danielwilczak101/EasyControls/README.md

# EasyControls Overview:

ADD IMAGE OF CUBESAT AND FREE FLIER

### [EasyControls.org](http://easycontrols.org)
The website is used to allow users to upload their controls code and see how the spacecraft responds.
