danielwilczak101/EasyControls/ISAAC/RaspberryPi/Readme.md

This is where the code on the raspberry pi will kept. This includes control methods and downloading from the website http://easycontontrols.org
