danielwilczak101/EasyControls/docs/index.md

# Welcome to Easy Controls - Integrated Spacecraft Autonomous Attitude Controls - ISAAC 

Here Dylan will eventually finish the documentation for this project. Maybe... Maybe... he will. 

### How to get started using ISSAC

1. Need to power on ISSAC
