danielwilczak101/EasyControls/ISAAC/Poster.pptx

## EasyControls.org

- F.C.L.R Research Project

- Combine the two teams efforts to build a reusable throttleable rocket that can land and is controlled by using Data Driven “Machine Learning” Controls.

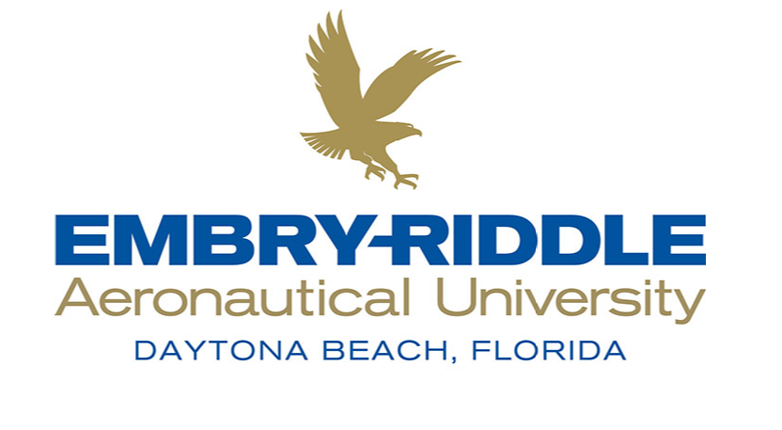
[picture p1: figure]

Mission Overview

- Build Open Source Reusable and Self Landing Liquid Rocket Technology
- Build Open Source Data Driven “Machine Learning” Control Technology

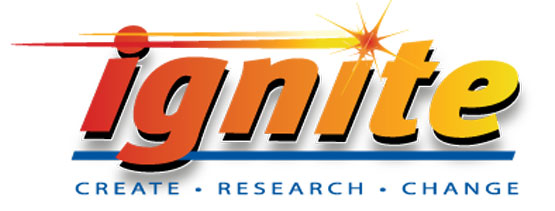
[picture p2: figure]

Data driven “ML” control

Data Driven “Machine Learning” Control Technology

- Rocket Control Prodotype

Reusable and Self Landing Liquid Rocket Technology

By Drawings by Leroy J. Krzycki. China Lake

Notes: To change this poster, replace our sample content with your own. Or, if you'd rather start from a clean slate, use the New Slide button on the Home tab to insert a new page, then enter your text and content in the empty placeholders. If you need more placeholders for titles, subtitles or body text, copy any of the existing placeholders, then drag the new one into place.
