danielwilczak101/EasyControls/ISAAC/Docs/SPARK/ISAAC-Purchase-Form.xlsx

Sheet: Instructions
Please click here to review the OUR Purchasing Guidelines prior to completing this form.
Purchase Request Form: • Used to request the purchase of all supplies/materials as needed. • Group all items by vendor. • Purchase from Amazon whenever possible. • Include any special instructions/details. • Include additional info for electronic and hazardous items in tabs below (required). • Provide direct links to exact item requested. • Provide shipping estimates. • Provide item ID #. • Provide lab/building address for shipment in email.
Electronic, computer & software purchases: • IT APPROVAL REQUIRED. • Provide a brief description of what the item(s) will be used for on the "Electronic Items" tab below. • OUR will obtain IT approval on your behalf. • Includes but not limited to: external hard drives, motherboards, Raspberry Pi, cameras, laptops, printers, etc.
Hazardous, chemical & gas purchases: • EH&S Review and Acceptance REQUIRED before purchasing. • You and your Faculty Mentor are responsible for obtaining a review and acceptance of your comprehensive SOP by the University’s Environmental Health & Safety Office prior to submitting Purchase Requests for hazardous, chemical, or gas purchases. • Complete the “Chemical & Compressed Gas Purchase” form linked in the "Hazardous & Chemicals" Tab below. • Once review is completed by EH&S, submit the acceptance with your Purchase Request Form to the OUR Business Manager and complete "Hazardous & Chemicals" Tab below.
Single Purchases $3,000 or more: • Due to the high expense, a Purchase Requisition must be submitted to purchase the item. • You must provide to the Business Manager along with your completed Purchase Request Form an itemized quote from the vendor and a copy of the vendor’s W-9 Form. • Single Purchases $5,000 or more are considered Capital Requests and require additional paperwork and approvals. • Please plan to purchase items of this nature as soon as possible as it often takes longer to process and receive the item.

Sheet: Purchase Request
 | Student Name: | Jacob R. Romeo |  | Project Title: | Integrated Spacecraft Autonomous Attitude Control |  |  | Type of Funding (Spark, Ignite, Student Internal, SURF): |  | Spark
 | SHIP TO: (Faculty / Lab Director Name) | Engineering Physics Propulsion lab |  | Lab / Building Name and Building # : | COAS |  |  |  | Room # : | 123
 | Group items by vendor and include all relevant information needed for ordering. Email a copy of this to Liz Payne: paynee6@erau.edu.
 | ***Additional info MUST be provided on tabs below for ALL electronic, computer and hazardous/chemical items.***
 |  |  |  |  |  |  | Est. Total for All Items Requested: |  | $975.00 | Actual Total: | $895.30
Line # | Vendor | Item | Product # / SKU | Ordering Instructions / Notes | Link | Quantity | Price Each | Est. Shipping Cost | Estimated Total | Actual Total - Inc. Shipping Fee (Purchaser will complete this) | Notes from Purchaser
1 | Mouser | Voltage Reference | AD586JRZ-REEL7 |  | https://www.mouser.com/ProductDetail/Analog-Devices/AD586JRZ-REEL7?qs=NmRFExCfTkEQ7ye4ZY8tAg%3D%3D | 5 | $11.03 | $9.00 | $70.00 | $64.15
2 | Mouser | ON/OFF switch | 2MS6T4B3M2CES |  | https://www.mouser.com/ProductDetail/Dailywell/2MS6T4B3M2CES?qs=B6kkDfuK7%2FCZhGel7UMMow%3D%3D | 5 | $4.06 | $9.00 | $35.00 | $29.30
3 | Amazon | 3D Filament | B0C3VL4QNM |  | https://www.amazon.com/ELEGOO-Filament-Dimensional-Accuracy-Cardboard/dp/B0C3VL4QNM | 2 | $50.00 | $0.00 | $110.00 | $100.00
4 | JLCPCB | PCBs | N/A | *WILL GIVE LINK FOR ORDER ONCE FINISHED* | "Board is not complete" | 3 | $15.00 | $10.00 | $60.00 | $55.00
5 | VILROS | Raspberry Pi zero | RPZW |  | https://vilros.com/products/raspberry-pi-zero-w?variant=21355432837220 | 3 | $15.00 | $15.00 | $65.00 | $60.00
6 | VILROS | Raspberry Pi 4 | RP4B2GB |  | https://vilros.com/products/raspberry-pi-4-2gb-ram?src=raspberrypi | 3 | $45.00 | $15.00 | $160.00 | $150.00
7 | ALiExpress | Rotary Unions | 3001008L | MAKE SURE IT IS THAT EXACT PART # | https://www.aliexpress.us/item/3256802618228752.html?gatewayAdapt=glo2usa | 8 | $20.00 | $7.00 | $175.00 | $167.00
8 | Amazon | IMU | MPU9250 |  | https://www.googleadservices.com/pagead/aclk?ai=DChcSEwjV-JyC8sSBAxWeRH8AHYyuBDIYABAFGgJvYQ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 | 3 | $15.00 | $10.00 | $60.00 | $55.00
9 | DigiKey | BNO055 | 1528-4646-ND |  | https://www.digikey.com/en/products/detail/adafruit-industries-llc/4646/12609996 | 3 | $29.95 | $15.00 | $110.00 | $104.85
10 | Amazon | Micro SD | SDSQUNB-032G-GN3MN |  | https://www.amazon.com/SanDisk-Ultra-SDSQUNB-032G-GN3MN-UHS-I-microSDHC/dp/B010NE3QHQ?hvadid=309773039951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 | 5 | $8.00 | $5.00 | $50.00 | $45.00
11 | Amazon | wires | B089D29FHC | 25ft | https://www.amazon.com/Fermerry-Stranded-Colors-Flexible-electrical/dp/B089D29FHC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 | 1 | $20.00 | $5.00 | $30.00 | $25.00
12 | Amazon | XT-60 plug | B07VRLQ2C5 |  | https://www.amazon.com/XT60PW-Female-Connector-Adapter-Battery/dp/B07VRLQ2C5 | 2 | $10.00 | $5.00 | $30.00 | $25.00
13 | Amazon | JST | B0B152V2W8 |  | https://www.amazon.com/Twidec-Connector-Housing-Adapter-Terminal/dp/B0B152V2W8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 | 1 | $10.00 | $5.00 | $20.00 | $15.00
14 |  |  |  |  |  |  |  |  |  | $0.00
15 |  |  |  |  |  |  |  |  |  | $0.00
16 |  |  |  |  |  |  |  |  | $0.00 | $0.00
17 |  |  |  |  |  |  |  |  | $0.00 | $0.00
18 |  |  |  |  |  |  |  |  | $0.00 | $0.00
19 |  |  |  |  |  |  |  |  | $0.00 | $0.00
20 |  |  |  |  |  |  |  |  | $0.00 | $0.00
21 |  |  |  |  |  |  |  |  | $0.00 | $0.00
22 |  |  |  |  |  |  |  |  | $0.00 | $0.00
23 |  |  |  |  |  |  |  |  | $0.00 | $0.00
24 |  |  |  |  |  |  |  |  | $0.00 | $0.00
25 |  |  |  |  |  |  |  |  | $0.00 | $0.00
26 |  |  |  |  |  |  |  |  | $0.00 | $0.00
27 |  |  |  |  |  |  |  |  | $0.00 | $0.00
28 |  |  |  |  |  |  |  |  | $0.00 | $0.00
29 |  |  |  |  |  |  |  |  | $0.00 | $0.00
30 |  |  |  |  |  |  |  |  | $0.00 | $0.00
31 |  |  |  |  |  |  |  |  | $0.00 | $0.00
32 |  |  |  |  |  |  |  |  | $0.00 | $0.00
33 |  |  |  |  |  |  |  |  | $0.00 | $0.00
34 |  |  |  |  |  |  |  |  | $0.00 | $0.00
35 |  |  |  |  |  |  |  |  | $0.00 | $0.00
36 |  |  |  |  |  |  |  |  | $0.00 | $0.00
37 |  |  |  |  |  |  |  |  | $0.00 | $0.00
38 |  |  |  |  |  |  |  |  | $0.00 | $0.00
39 |  |  |  |  |  |  |  |  | $0.00 | $0.00
40 |  |  |  |  |  |  |  |  | $0.00 | $0.00
41 |  |  |  |  |  |  |  |  | $0.00 | $0.00
42 |  |  |  |  |  |  |  |  | $0.00 | $0.00
43 |  |  |  |  |  |  |  |  | $0.00 | $0.00
44 |  |  |  |  |  |  |  |  | $0.00 | $0.00
45 |  |  |  |  |  |  |  |  | $0.00 | $0.00
46 |  |  |  |  |  |  |  |  | $0.00 | $0.00
47 |  |  |  |  |  |  |  |  | $0.00 | $0.00
48 |  |  |  |  |  |  |  |  | $0.00 | $0.00
49 |  |  |  |  |  |  |  |  | $0.00 | $0.00
50 |  |  |  |  |  |  |  |  | $0.00 | $0.00
51 |  |  |  |  |  |  |  |  | $0.00 | $0.00
52 |  |  |  |  |  |  |  |  | $0.00 | $0.00
53 |  |  |  |  |  |  |  |  | $0.00 | $0.00
54 |  |  |  |  |  |  |  |  | $0.00 | $0.00
55 |  |  |  |  |  |  |  |  | $0.00 | $0.00
56 |  |  |  |  |  |  |  |  | $0.00 | $0.00
57 |  |  |  |  |  |  |  |  | $0.00 | $0.00
58 |  |  |  |  |  |  |  |  | $0.00 | $0.00
59 |  |  |  |  |  |  |  |  | $0.00 | $0.00
60 |  |  |  |  |  |  |  |  | $0.00 | $0.00
61 |  |  |  |  |  |  |  |  | $0.00 | $0.00
62 |  |  |  |  |  |  |  |  | $0.00 | $0.00
63 |  |  |  |  |  |  |  |  | $0.00 | $0.00
64 |  |  |  |  |  |  |  |  | $0.00 | $0.00
65 |  |  |  |  |  |  |  |  | $0.00 | $0.00
66 |  |  |  |  |  |  |  |  | $0.00 | $0.00
67 |  |  |  |  |  |  |  |  | $0.00 | $0.00
68 |  |  |  |  |  |  |  |  | $0.00 | $0.00
69 |  |  |  |  |  |  |  |  | $0.00 | $0.00
70 |  |  |  |  |  |  |  |  | $0.00 | $0.00
71 |  |  |  |  |  |  |  |  | $0.00 | $0.00
72 |  |  |  |  |  |  |  |  | $0.00 | $0.00
73 |  |  |  |  |  |  |  |  | $0.00 | $0.00
74 |  |  |  |  |  |  |  |  | $0.00 | $0.00
75 |  |  |  |  |  |  |  |  | $0.00 | $0.00
76 |  |  |  |  |  |  |  |  | $0.00 | $0.00
77 |  |  |  |  |  |  |  |  | $0.00 | $0.00
78 |  |  |  |  |  |  |  |  | $0.00 | $0.00
79 |  |  |  |  |  |  |  |  | $0.00 | $0.00
80 |  |  |  |  |  |  |  |  | $0.00 | $0.00
81 |  |  |  |  |  |  |  |  | $0.00 | $0.00
82 |  |  |  |  |  |  |  |  | $0.00 | $0.00
83 |  |  |  |  |  |  |  |  | $0.00 | $0.00
84 |  |  |  |  |  |  |  |  | $0.00 | $0.00
85 |  |  |  |  |  |  |  |  | $0.00 | $0.00
86 |  |  |  |  |  |  |  |  | $0.00 | $0.00
87 |  |  |  |  |  |  |  |  | $0.00 | $0.00
88 |  |  |  |  |  |  |  |  | $0.00 | $0.00
89 |  |  |  |  |  |  |  |  | $0.00 | $0.00
90 |  |  |  |  |  |  |  |  | $0.00 | $0.00
91 |  |  |  |  |  |  |  |  | $0.00 | $0.00
92 |  |  |  |  |  |  |  |  | $0.00 | $0.00
93 |  |  |  |  |  |  |  |  | $0.00 | $0.00
94 |  |  |  |  |  |  |  |  | $0.00 | $0.00
95 |  |  |  |  |  |  |  |  | $0.00 | $0.00
96 |  |  |  |  |  |  |  |  | $0.00 | $0.00
97 |  |  |  |  |  |  |  |  | $0.00 | $0.00
98 |  |  |  |  |  |  |  |  | $0.00 | $0.00
99 |  |  |  |  |  |  |  |  | $0.00 | $0.00
100 |  |  |  |  |  |  |  |  | $0.00 | $0.00
 |  |  |  |  |  |  |  |  | $0.00 | $0.00

Sheet: Electronic Items
All electronic, computer, and technology items must be approved by IT prior to purchasing. The info below is required so that we can obtain IT approval on your behalf.
Line # from Purchase Request Form | Justification (why is the item needed, where will it be used / stored, will it be connected to the University network, etc.)
5 | For testing and upgrades and future development
6 | For testing and upgrades as well as future development

Sheet: Hazardous & Chemical Items
ALL hazardous and chemical items require review and acceptance by Environmental Health & Safety. You and your Faculty Mentor are required to obtain EH&S review and acceptance of a comprehensive SOP prior to requesting hazardous items.
Line # from Purchase Request Form | Link to Safety Data Sheet | Chemical & Compressed Gas Purchase Form submitted to EH&S for hazardous items? Select Yes or No (https://ernie.erau.edu/Departments/ehs/Pages/Forms.aspx) | SOP Reviewed and Accepted by EH&S? Select Yes or No
