danielwilczak101/EasyControls/Cubesat/PCB/CubeSat/CubeSat.step

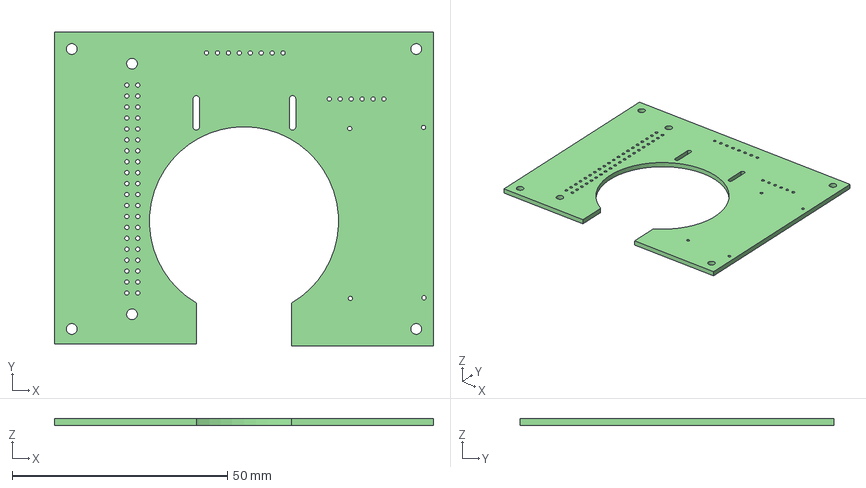
[picture p9: CAD file, 2022-09-25]
Cubesat/PCB/CubeSat/CubeSat.step
88.0 x 73.0 x 1.60 mm
