danielwilczak101/EasyControls/Cubesat/PCB/MJBOTS-CubeSat/CubeSat.step

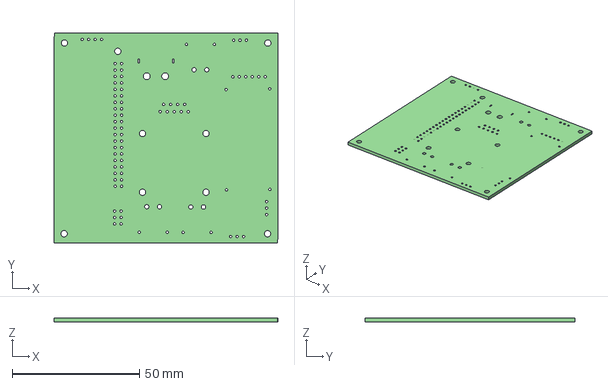
[picture p10: CAD file, 2022-11-11]
Cubesat/PCB/MJBOTS-CubeSat/CubeSat.step
88.1 x 82.7 x 1.60 mm
