danielwilczak101/EasyControls/ISAAC/PCB/Pi_HAT/V5/Pi_HAT_V5_Simple/Symbols/BSS138_RFG.step

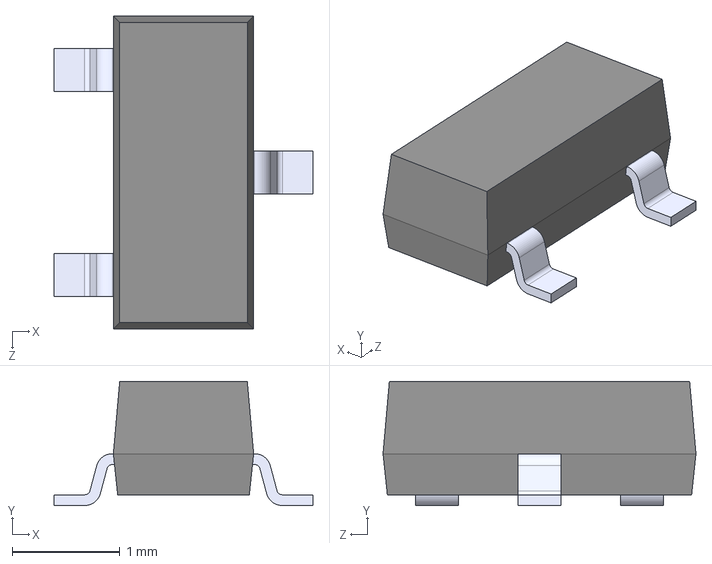
[picture p11: CAD file, 2022-09-25]
ISAAC/PCB/Pi_HAT/V5/Pi_HAT_V5_Simple/Symbols/BSS138_RFG.step
2.40 x 1.15 x 2.90 mm
