danielwilczak101/EasyControls/ISAAC/PCB/Spacecraft ATmega328 MOSFET/kicad_library/3DModel/ECS-160-20-5PXDN-TR.step

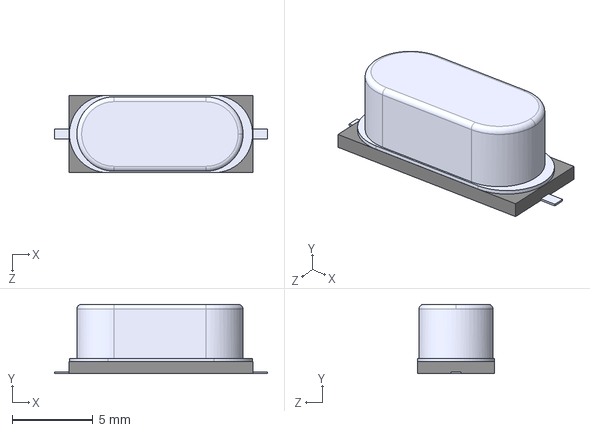
[picture p12: CAD file, 2022-04-26]
ISAAC/PCB/Spacecraft ATmega328 MOSFET/kicad_library/3DModel/ECS-160-20-5PXDN-TR.step
13.2 x 4.30 x 4.80 mm
