danielwilczak101/EasyControls/ISAAC/PCB/Pi_HAT/V5/Pi_HAT_V5_Simple/Symbols/XT60PW-M.step

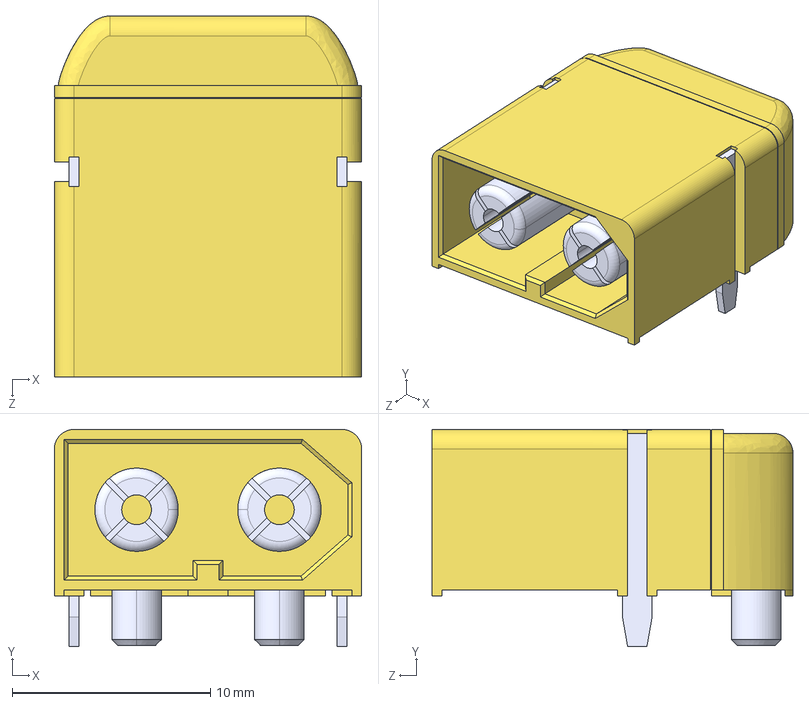
[picture p13: CAD file, 2022-04-24]
ISAAC/PCB/Pi_HAT/V5/Pi_HAT_V5_Simple/Symbols/XT60PW-M.step
15.5 x 10.9 x 18.2 mm
