danielwilczak101/EasyControls/ISAAC/PCB/Spacecraft ATmega328 MOSFET/kicad_library/3DModel/T491A104K035AT.step

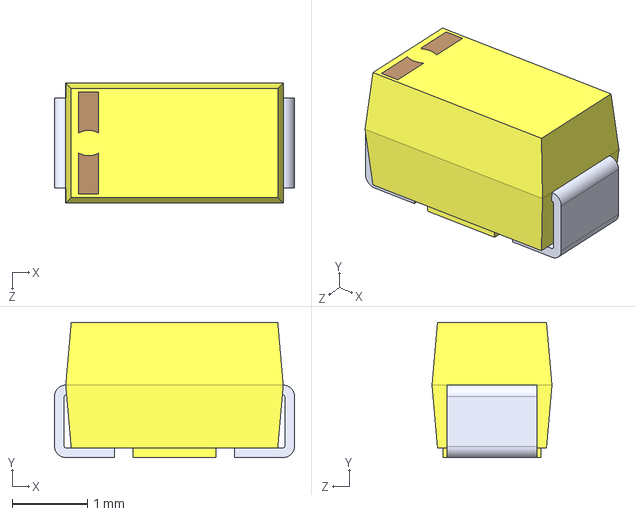
[picture p14: CAD file, 2022-04-26]
ISAAC/PCB/Spacecraft ATmega328 MOSFET/kicad_library/3DModel/T491A104K035AT.step
3.20 x 1.80 x 1.60 mm
