danielwilczak101/EasyControls/ISAAC/PCB/Pi_HAT/V5/Pi_HAT_V5_Simple/Symbols/VREG_L7805ACD2T.step

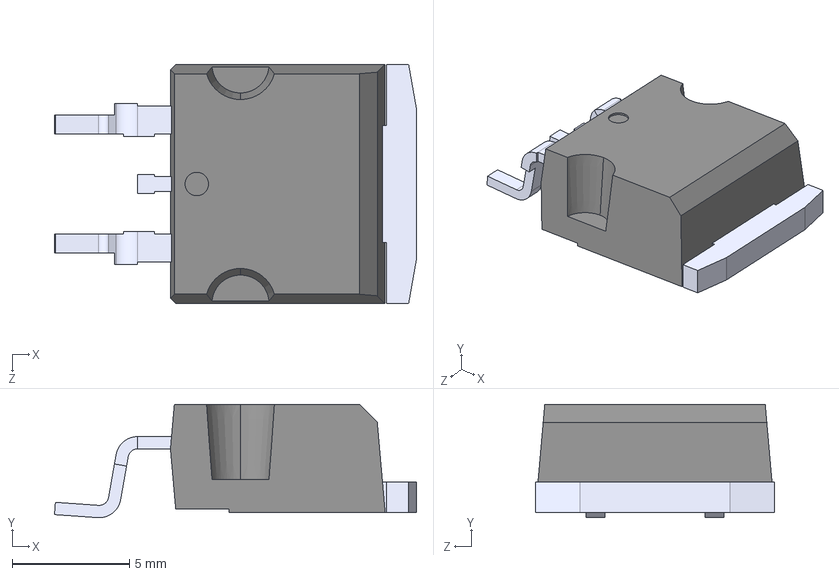
[picture p15: CAD file, 2022-04-24]
ISAAC/PCB/Pi_HAT/V5/Pi_HAT_V5_Simple/Symbols/VREG_L7805ACD2T.step
15.4 x 4.83 x 10.2 mm
