danielwilczak101/EasyControls/ISAAC/PCB/Spacecraft ATmega328 MOSFET/kicad_library/3DModel/BOB-12009.step

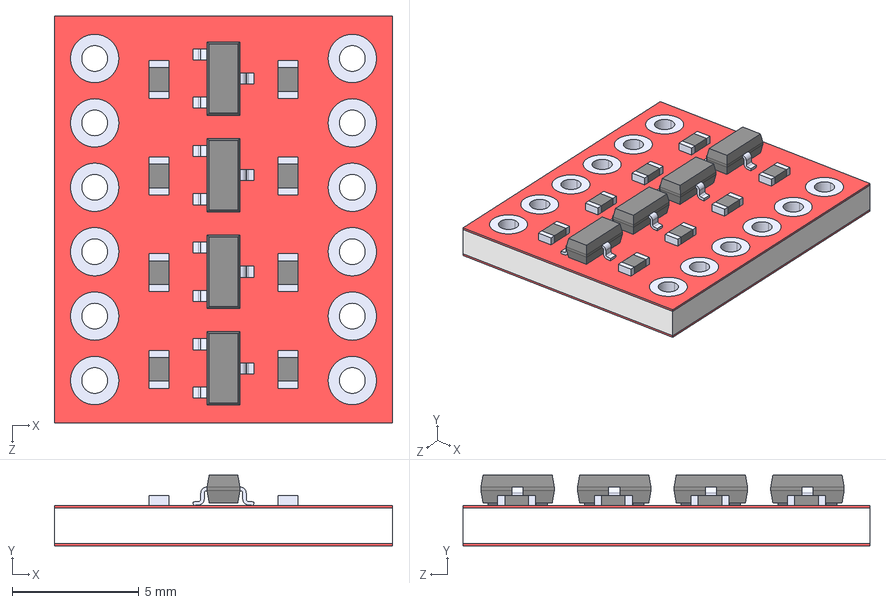
[picture p16: CAD file, 2022-04-26]
ISAAC/PCB/Spacecraft ATmega328 MOSFET/kicad_library/3DModel/BOB-12009.step
13.3 x 2.80 x 16.1 mm
