danielwilczak101/EasyControls/ISAAC/testing/README.md

All testing requirements will be accomplished in this directory.

### How it works:
1. State test requirement in general language.  
2. State non requirements.  
3. State what is expected after the test. (files,diagrams, etc).  

### Optional:
1. State any required information the test might need to accomplish the test.  

### How to make test - Example:
```
## Test Requirements:
Assemble mosfet board and fire valve.   
    - Tank pressue is optional but please detail in readme.  
    - Does not require I2C communication to the chip.  

## File Requirements:  
1.Ardunio Code.  
2.Wiring Diagram(Hand written or drawen out).  
```
