danielwilczak101/EasyControls/ISAAC/testing/IMUData/README.md

This file contains the code in development to retrieve IMU data from the Arduino to the Raspberry Pi.
