danielwilczak101/EasyControls/ISAAC/testing/pi_ssh_and_vnc/README.md

## Test Completed:
Setup Raspberry Pi on spacecraft with SSH. 
    - Be on lab Wifi.  
    - Run python script to validate everything works.

## File Requirements:
1. Python Code.  
2. Connection details.

# SSH Connection

### For Linux/Mac open up terminal window and type:
```bash
ssh pi@192.168.88.80
```
Enter Password: Dmw0234567 

Congratulations you succesfully SSH into the Raspberry Pi! 

### For Windows downlaod an SSH client like Putty:

Link to Download Putty:
https://www.chiark.greenend.org.uk/~sgtatham/putty/latest.html

Open Putty and select SSH

Enter
```
IP Adress: 192.168.88.80
Username: pi
Password: Dmw0234567
```
Congratulations you succesfully SSH into the Raspberry Pi! 

# VNC Connection

### For Linux, Mac, and Windows download VNC Viewer Application

Link to Download VNC Viewer:
https://www.realvnc.com/en/connect/download/viewer/

In order to connect:
```
Enter IP Address: 192.168.88.80

Enter Username: pi

Enter Password: Dmw0234567
```

Congratulations you succesfully VNC into the Raspberry Pi! 

4. Instructions on how to set this up.
5. (Optional) Find or ask dan for cheap router so we can have this setup for the confrence.
