danielwilczak101/EasyControls/ISAAC/testing/tank_servo/README.md

## Test Completed:
Testing information below.

## Servo info
Model - HS-7980TH

## Big things to note
```C++
// Perpindicular to the pipe 
Servo1.write(45); 
   
// Parrellel to the pipe
Servo1.write(140); 
```

## Wiring
```
White  - PWM
Orange - 5v
Blue   - Gnd
```

## Image
Wiring Breadboard
