danielwilczak101/EasyControls/ISAAC/testing/tank_thermocouple/README.md

## Test Completed:
Read thermocouple data that comes from the tank. 
    - Read tank thermocouple data.  

## File Requirements:
1. Python Code or ardunio code.  
2. Wiring diagram (Can be hand written or drawn out).

## Wiring
CS - Any digital pin (default GPIO 17, board pin 11)  
SCK - SCLK (GPIO 11)  
SDO - MISO (GPIO 9)  
SDI - MOSO (GPIO 10)  
Vin - 5V or 3V  
GND - Ground
