danielwilczak101/EasyControls/ISAAC/testing/thruster_force/README.md

## Test Completed:
Assemble pressurize valve to operationg pressure and see how many Newtons of force it produces over time.   

### Thrust values:
Thrust from test stand nozzle with following psi going to the solinoid.
```
40 psi = 30g
60 psi = 60g
80 psi = 90g
95 psi  = 101 - 105g
100 psi = 100 - 113g 
130 psi = 130 - 136g
```
    
Wiring Breadboard

Wiring Breadboard
