danielwilczak101/EasyControls/ISAAC/testing/thruster_led/README.md

## Test Completed:
Test LED curcuit that uses digital signal to change the leds.   
    - Show firing of left and right.
    - CHange colors.
    - Does not require I2C communication to the chip.  

## File Requirements:
1.Ardunio Code.  

## Wiring
5v to 5v
Gnd to Gnd
DIN to digital pin 2 or whatever we want

## Color picker
https://www.google.com/search?q=rgb+color+picker

## Purchased LEDS
https://www.adafruit.com/product/1426  

## Tutorial:  
https://learn.adafruit.com/adafruit-neopixel-uberguide/arduino-library-use  

## Image
Wiring Breadboard
