danielwilczak101/EasyControls/ISAAC/testing/thruster_firing/README.md

## Test Requirements:
Assemble mosfet board and fire valve.   
    - Use lab pressure. See what the fastest speed we can oscillate the solinoid before it locks.
    - Does not require I2C communication to the chip.  

## File Requirements:
1.Ardunio Code.  
2.Wiring Diagram(Hand written or drawen out).
