danielwilczak101/EasyControls/ISAAC/testing/atmega328PAU_bootloader_program/images/1.png

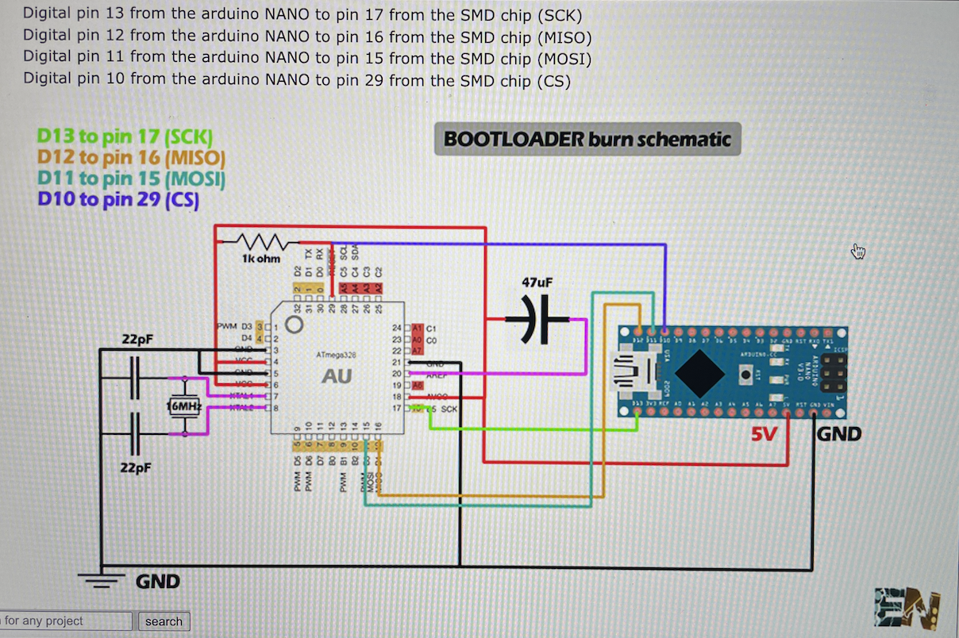
ISAAC/testing/atmega328PAU_bootloader_program/images/1.png
