danielwilczak101/EasyControls/ISAAC/PCB/Pi_HAT/V5/Pi_HAT_V5_Simple/Pi_HAT_V5_Simple.kicad_pcb

## KiCad design ISAAC/PCB/Pi_HAT/V5/Pi_HAT_V5_Simple/Pi_HAT_V5_Simple.kicad_pcb (2024-03-04)

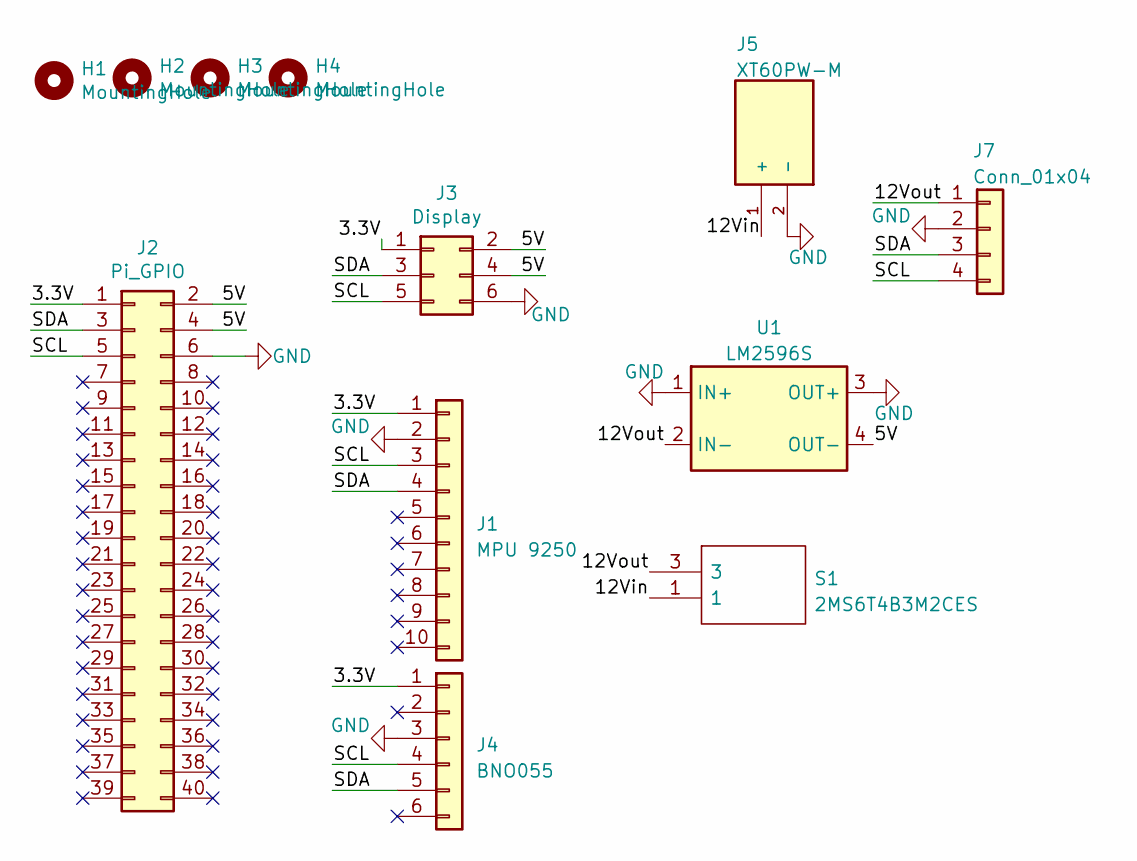
[picture p26: schematic Pi_HAT_V5_Simple.kicad_sch]

Parts:
H1, H2, H3, H4: MountingHole; MountingHole_2.5mm
J1: MPU 9250; PinHeader_1x10_P2.54mm_Vertical
J2: Pi_GPIO; PinHeader_2x20_P2.54mm_Vertical
J3: Display; PinHeader_2x03_P2.54mm_Vertical
J4: BNO055; PinHeader_1x06_P2.54mm_Vertical
J5: XT60PW-M; AMASS_XT60PW-M; PARTREV V1.2
J7: Conn_01x04; PinHeader_1x04_P2.54mm_Vertical
S1: 2MS6T4B3M2CES; Mouser Part Number 118-2MS6T4B3M2CES
U1: LM2596S; LM2596S_mod

Connections:
/3.3V: J1.1, J2.1, J3.1, J4.1
/5V: J2.2, J2.4, J3.2, J3.4, U1.4 (OUT-)
/12Vin: J5.1 (+), S1.1
/12Vout: J7.1, S1.3, U1.2 (IN-)
/SCL: J1.3, J2.5, J3.5, J4.4, J7.4
/SDA: J1.4, J2.3, J3.3, J4.5, J7.3
GND: J1.2, J2.6, J3.6, J4.3, J5.2 (-), J7.2, U1.1 (IN+), U1.3 (OUT+)

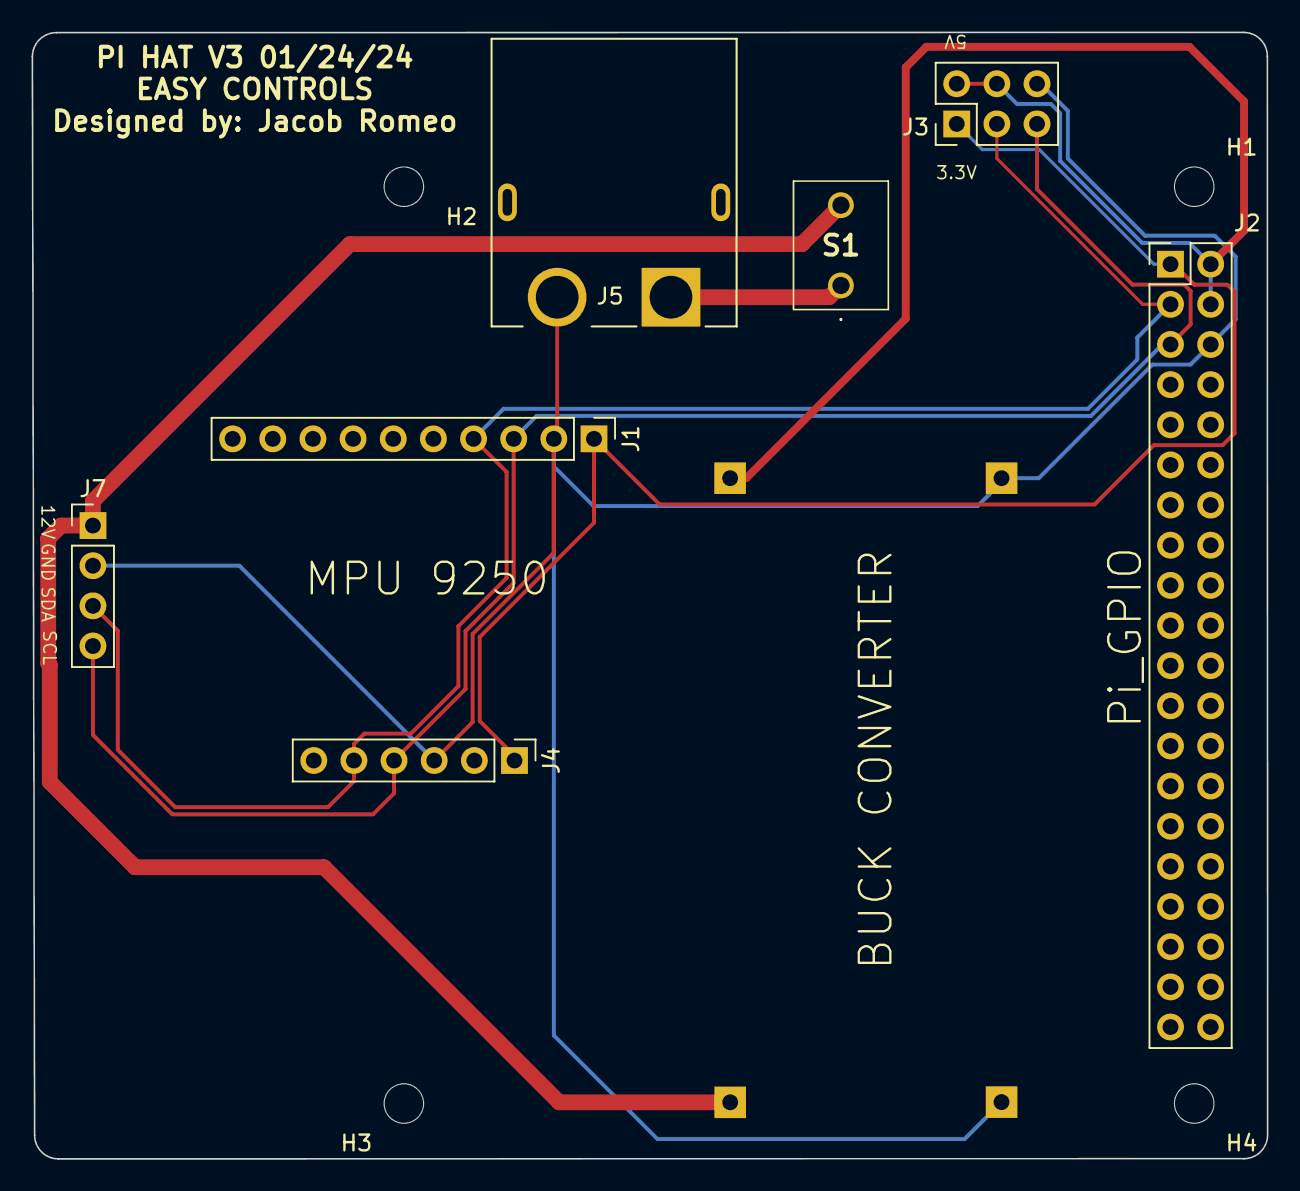
[picture p27: board Pi_HAT_V5_Simple.kicad_pcb from above]

Board: 2 copper layers, 78.1 x 71.3 mm, 12 parts (1 on the bottom side), 7 nets.
