danielwilczak101/EasyControls/ISAAC/PCB/Pi_HAT/V4/Pi_HAT_V4/Pi_HAT_V4.kicad_pcb

## KiCad design ISAAC/PCB/Pi_HAT/V4/Pi_HAT_V4/Pi_HAT_V4.kicad_pcb (2024-02-06, an earlier design)

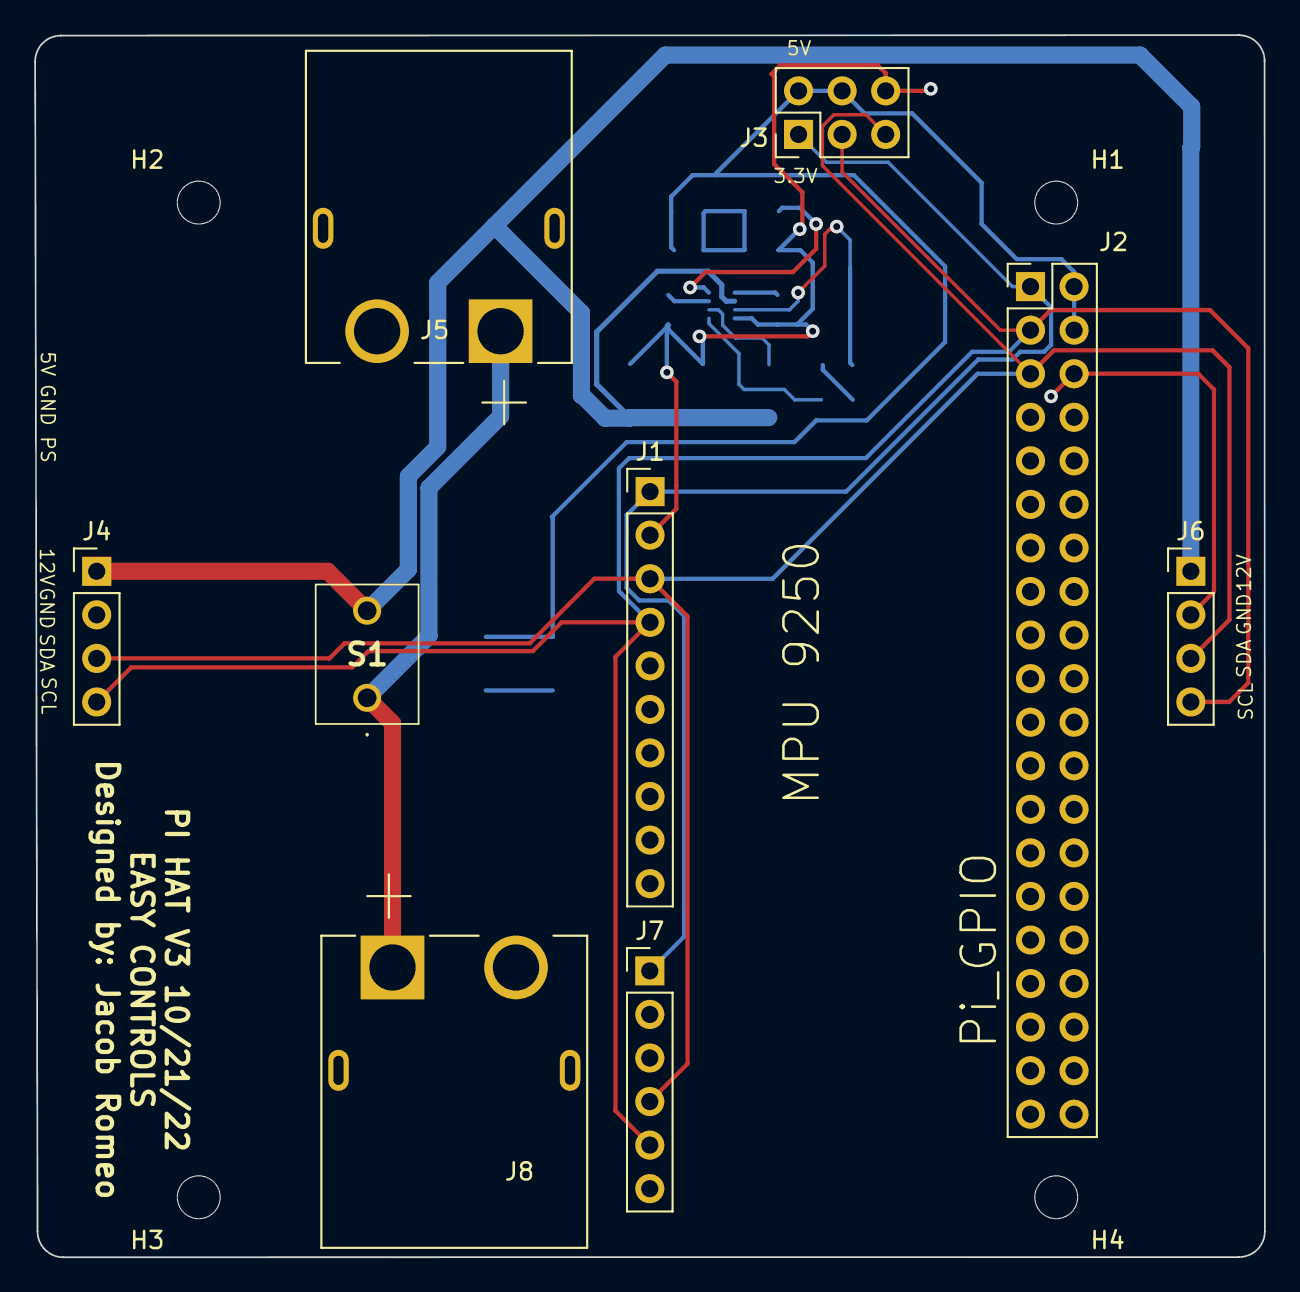
[picture p28: board Pi_HAT_V4.kicad_pcb from above]

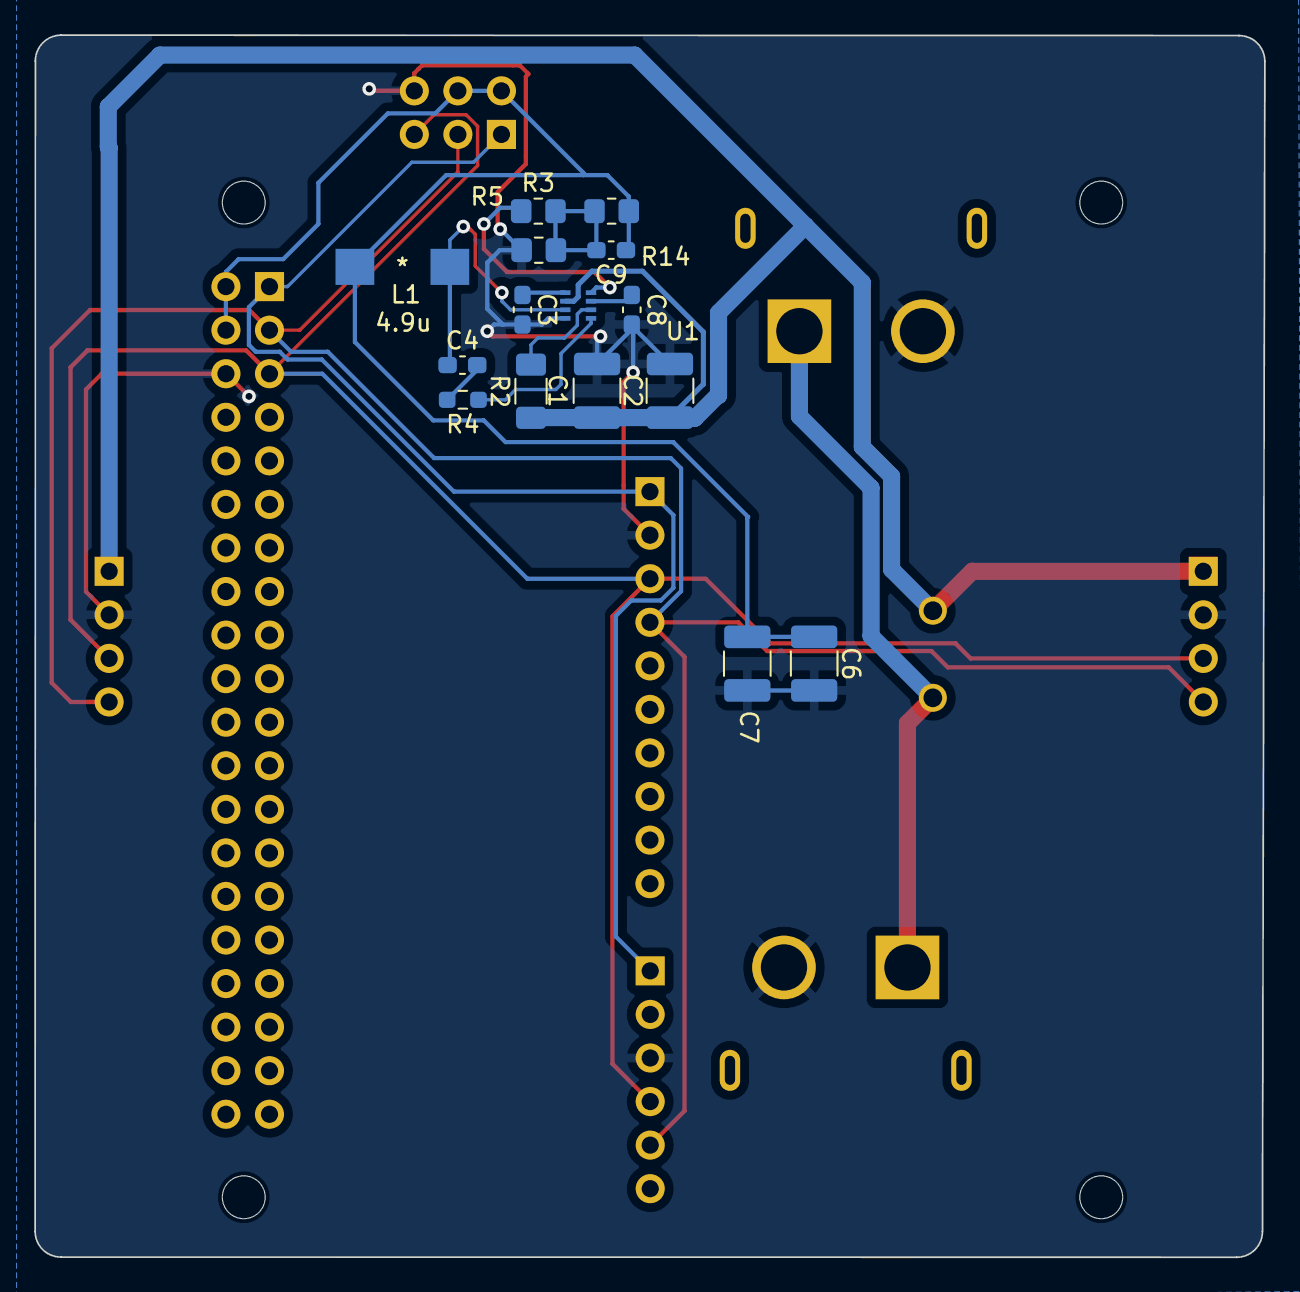
[picture p29: board Pi_HAT_V4.kicad_pcb from below]

Board: 2 copper layers, 71.7 x 71.3 mm, 28 parts (15 on the bottom side), 15 nets.

Parts:
C1, C6, C7: 22u; C_1210_3225Metric_Pad1.33x2.70mm_HandSolder
C2: 0.1u; C_1210_3225Metric_Pad1.33x2.70mm_HandSolder
C3: 1n; C_0603_1608Metric_Pad1.08x0.95mm_HandSolder
C4: 1u; C_0603_1608Metric_Pad1.08x0.95mm_HandSolder
C8: 6.8n; C_0603_1608Metric_Pad1.08x0.95mm_HandSolder
C9: 10p; C_0603_1608Metric_Pad1.08x0.95mm_HandSolder
H1, H2, H3, H4: MountingHole; MountingHole_2.5mm
J1: MPU 9250; PinHeader_1x10_P2.54mm_Vertical
J2: Pi_GPIO; PinHeader_2x20_P2.54mm_Vertical
J3: Display; PinHeader_2x03_P2.54mm_Vertical
J4, J6: Conn_01x04_Male; PinHeader_1x04_P2.54mm_Vertical
J5, J8: XT60PW-M; AMASS_XT60PW-M
J7: BNO055; PinHeader_1x06_P2.54mm_Vertical
L1: 4.9u; 744777004
R2: 604k; R_1206_3216Metric_Pad1.30x1.75mm_HandSolder
R3: 15k; R_0805_2012Metric_Pad1.20x1.40mm_HandSolder
R4: 20; R_0603_1608Metric_Pad0.98x0.95mm_HandSolder
R5: 7.68K; R_0805_2012Metric_Pad1.20x1.40mm_HandSolder
R14: 40.2k; R_0805_2012Metric_Pad1.20x1.40mm_HandSolder
S1: Switch; 2MS6T4B3M2CES
U1: MP2315GJ-Z; MP2393GTL-P

Connections:
/3.3V: J1.1, J2.1, J3.1, J7.1
/5V: C6.1, C7.1, C9.1, J2.2, J2.4, J3.2, J3.4, L1.2, R14.1
/12V: C1.1, C2.1, J4.1, J6.1, R2.1, S1.3, U1.2 (IN)
/Buck Converter/12Vin: J5.1 (+), J8.1 (+), S1.1
/SCL: J1.3, J2.5, J3.5, J4.3, J6.3, J7.4
/SDA: J1.4, J2.3, J3.3, J4.4, J6.4, J7.5
GND: C1.2, C2.2, C3.2, C6.2, C7.2, C8.2, J1.2, J2.6, J3.6, J4.2, J5.2 (-), J6.2, J7.3, J8.2 (-), R5.1, U1.4 (GND)
unnamed: C4.2, R4.2
unnamed: C9.2, R3.2, R5.2, R14.2
unnamed: R4.1, U1.5 (BST)
unnamed: R2.2, U1.6 (EN/SYNC)
unnamed: R3.1, U1.8 (FB)
unnamed: C3.1, U1.1 (PG)
unnamed: C8.1, U1.7 (SS)
unnamed: C4.1, L1.1, U1.3 (SW)
