danielwilczak101/EasyControls/ISAAC/PCB/Pi_HAT/V3/Pi_HAT_V3_simple/Pi_HAT_Simple_V3.kicad_pcb

## KiCad design ISAAC/PCB/Pi_HAT/V3/Pi_HAT_V3_simple/Pi_HAT_Simple_V3.kicad_pcb (2022-11-24, an earlier design)

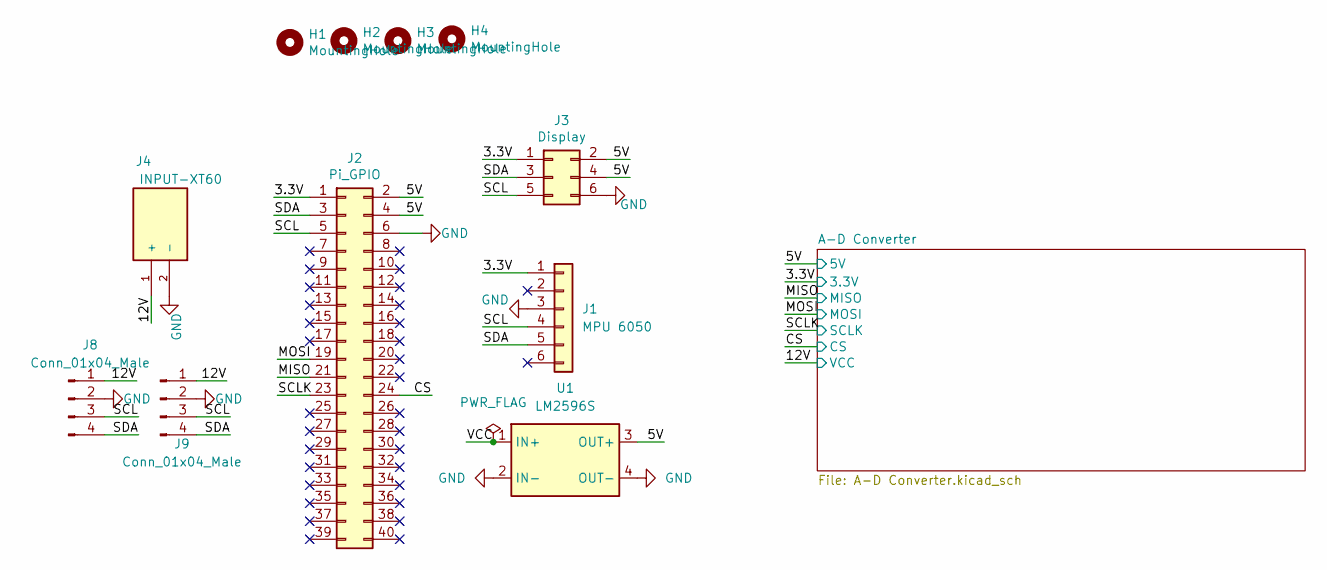
[picture p30: schematic Pi_HAT_Simple_V3.kicad_sch]

Parts:
H1, H2, H3, H4: MountingHole; MountingHole_2.5mm
J1: MPU 6050; PinHeader_1x06_P2.54mm_Vertical
J2: Pi_GPIO; PinHeader_2x20_P2.54mm_Vertical
J3: Display; PinHeader_2x03_P2.54mm_Vertical
J4: INPUT-XT60; AMASS_XT60PW-M; PARTREV V1.2
J8, J9: Conn_01x04_Male; PinHeader_1x04_P2.54mm_Vertical
U1: LM2596S; LM2596S_mod

Connections:
/3.3V: J1.1, J2.1, J3.1; also elsewhere on the board
/5V: J2.2, J2.4, J3.2, J3.4, U1.3 (OUT+); also elsewhere on the board
/12V: J4.1 (+), J8.1, J9.1; also elsewhere on the board
/CS: J2.24; also elsewhere on the board
/MISO: J2.21; also elsewhere on the board
/MOSI: J2.19; also elsewhere on the board
/SCL: J1.4, J2.5, J3.5, J8.3, J9.3
/SCLK: J2.23; also elsewhere on the board
/SDA: J1.5, J2.3, J3.3, J8.4, J9.4
/VCC: U1.1 (IN+)
GND: J1.3, J2.6, J3.6, J4.2 (-), J8.2, J9.2, U1.2 (IN-), U1.4 (OUT-); also elsewhere on the board

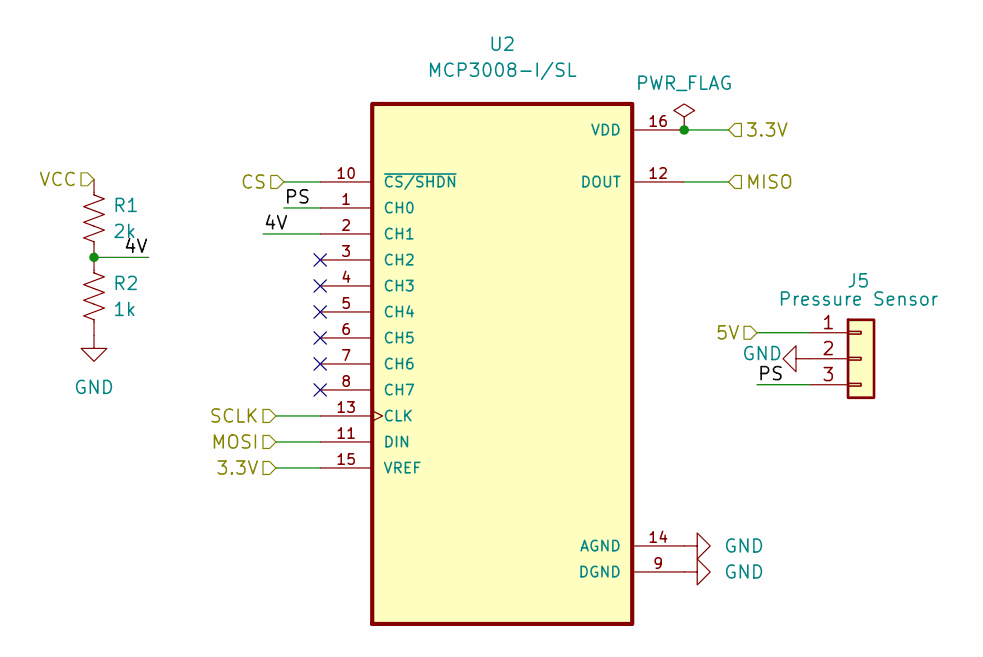
[picture p31: schematic A-D Converter.kicad_sch]

Parts:
J5: Pressure Sensor; PinHeader_1x03_P2.54mm_Vertical
R1: 2k; R_0805_2012Metric_Pad1.20x1.40mm_HandSolder
R2: 1k; R_0805_2012Metric_Pad1.20x1.40mm_HandSolder
U2: MCP3008-I/SL; SOIC127P600X175-16N

Connections:
/3.3V: U2.15 (VREF), U2.16 (VDD); also elsewhere on the board
/5V: J5.1; also elsewhere on the board
/12V: R1.1; also elsewhere on the board
/A-D Converter/4V: R1.2, R2.1, U2.2 (CH1)
/A-D Converter/PS: J5.3, U2.1 (CH0)
/CS: U2.10 (~CS/SHDN); also elsewhere on the board
/MISO: U2.12 (DOUT); also elsewhere on the board
/MOSI: U2.11 (DIN); also elsewhere on the board
/SCLK: U2.13 (CLK); also elsewhere on the board
GND: J5.2, R2.2, U2.9 (DGND), U2.14 (AGND); also elsewhere on the board

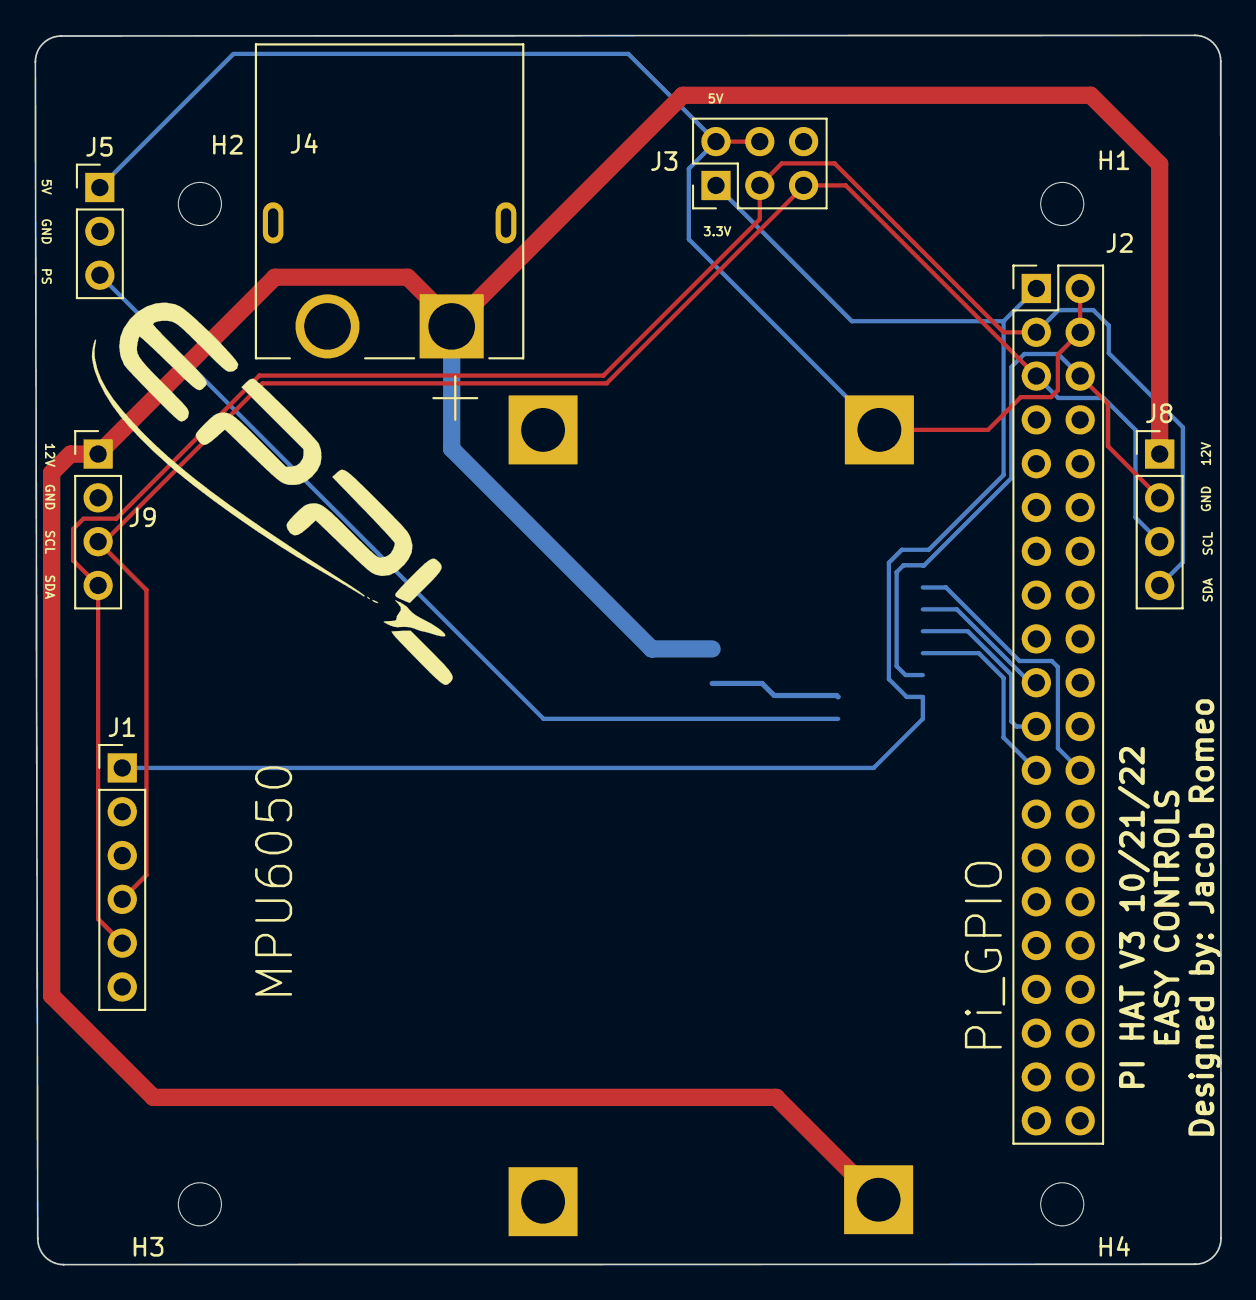
[picture p32: board Pi_HAT_Simple_V3.kicad_pcb from above]

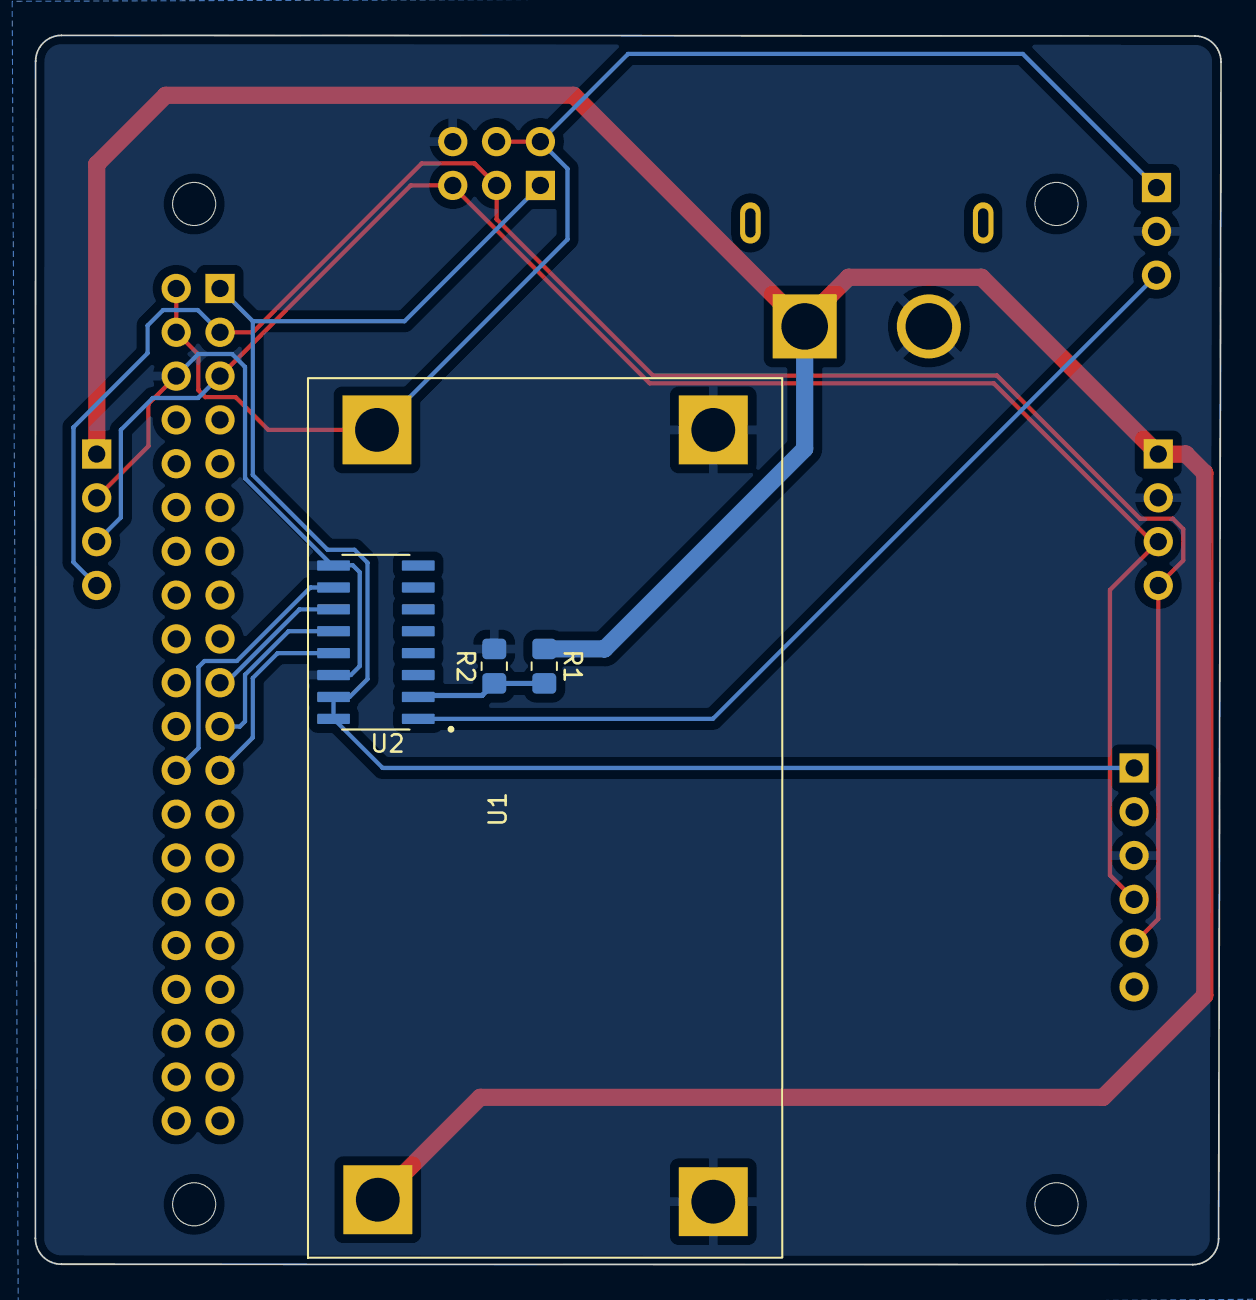
[picture p33: board Pi_HAT_Simple_V3.kicad_pcb from below]

Board: 2 copper layers, 68.7 x 71.3 mm, 15 parts (4 on the bottom side), 12 nets.
