danielwilczak101/EasyControls/Cubesat/PCB/MJBOTS-CubeSat/MJBOTS-CubeSat.kicad_pcb

## KiCad design Cubesat/PCB/MJBOTS-CubeSat/MJBOTS-CubeSat.kicad_pcb (2022-11-24)

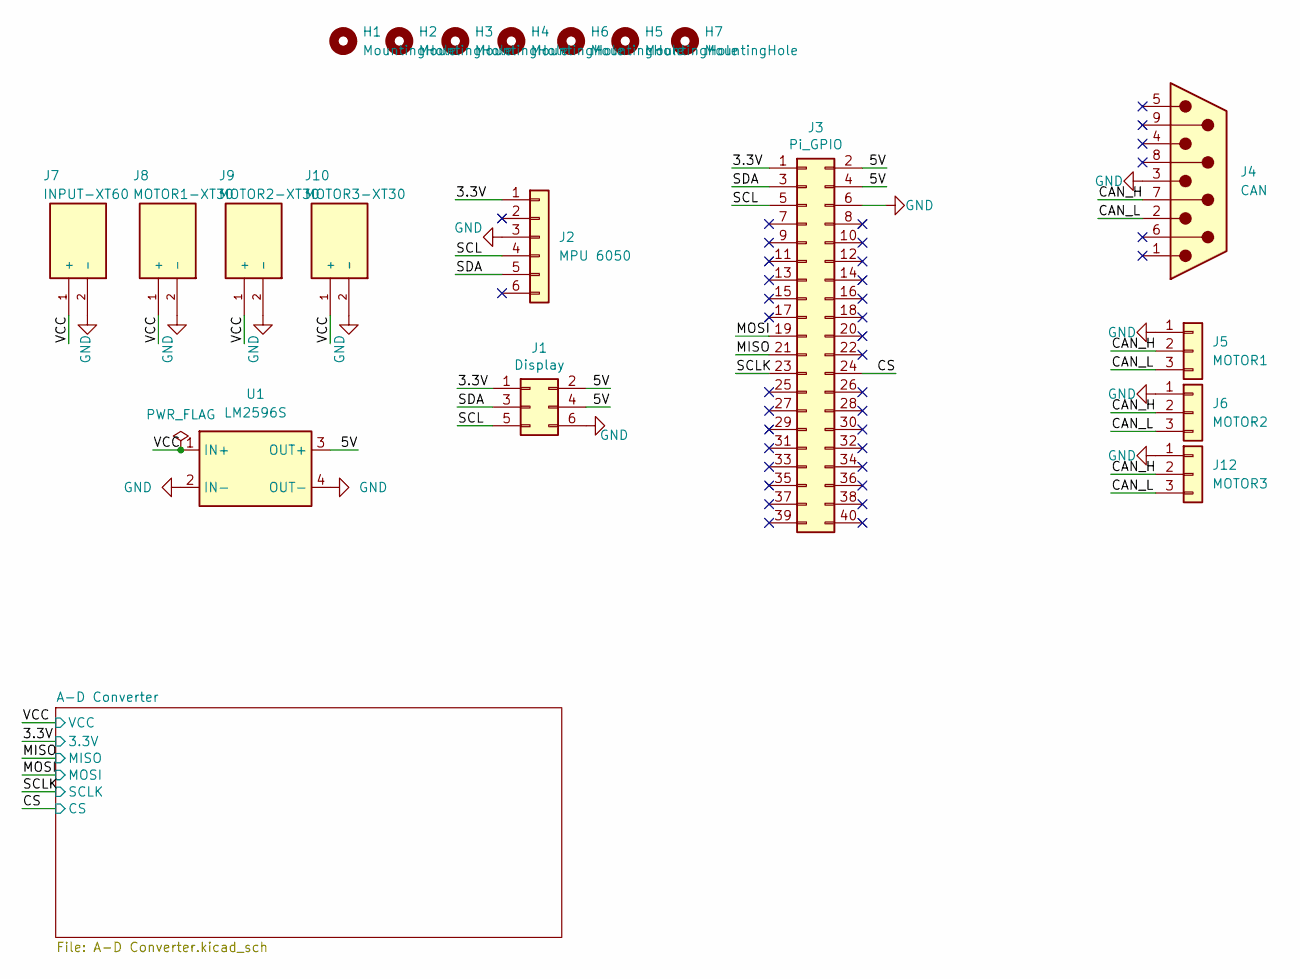
[picture p34: schematic MJBOTS-CubeSat.kicad_sch]

Parts:
H1, H2, H3, H4, H5, H6, H7: MountingHole; MountingHole_2.5mm
J1: Display; PinHeader_2x03_P2.54mm_Vertical
J2: MPU 6050; PinHeader_1x06_P2.54mm_Vertical
J3: Pi_GPIO; PinHeader_2x20_P2.54mm_Vertical
J4: CAN; DSUB-9_Male_Vertical_P2.77x2.84mm
J5: MOTOR1; PinHeader_1x03_P2.54mm_Vertical
J6: MOTOR2; PinHeader_1x03_P2.54mm_Vertical
J7: INPUT-XT60; AMASS_XT60PW-M; PARTREV V1.2
J8: MOTOR1-XT30; XT30PWM; PARTREV V1.2
J9: MOTOR2-XT30; XT30PWM; PARTREV V1.2
J10: MOTOR3-XT30; XT30PWM; PARTREV V1.2
J12: MOTOR3; PinHeader_1x03_P2.54mm_Vertical
U1: LM2596S; LM2596S_mod

Connections:
/3.3V: J1.1, J2.1, J3.1; also elsewhere on the board
/5V: J1.2, J1.4, J3.2, J3.4, U1.3 (OUT+)
/CAN_H: J4.7, J5.2, J6.2, J12.2
/CAN_L: J4.2, J5.3, J6.3, J12.3
/CS: J3.24; also elsewhere on the board
/MISO: J3.21; also elsewhere on the board
/MOSI: J3.19; also elsewhere on the board
/SCL: J1.5, J2.4, J3.5
/SCLK: J3.23; also elsewhere on the board
/SDA: J1.3, J2.5, J3.3
/VCC: J7.1 (+), J8.1 (+), J9.1 (+), J10.1 (+), U1.1 (IN+); also elsewhere on the board
GND: J1.6, J2.3, J3.6, J4.3, J5.1, J6.1, J7.2 (-), J8.2 (-), J9.2 (-), J10.2 (-), J12.1, U1.2 (IN-), U1.4 (OUT-); also elsewhere on the board

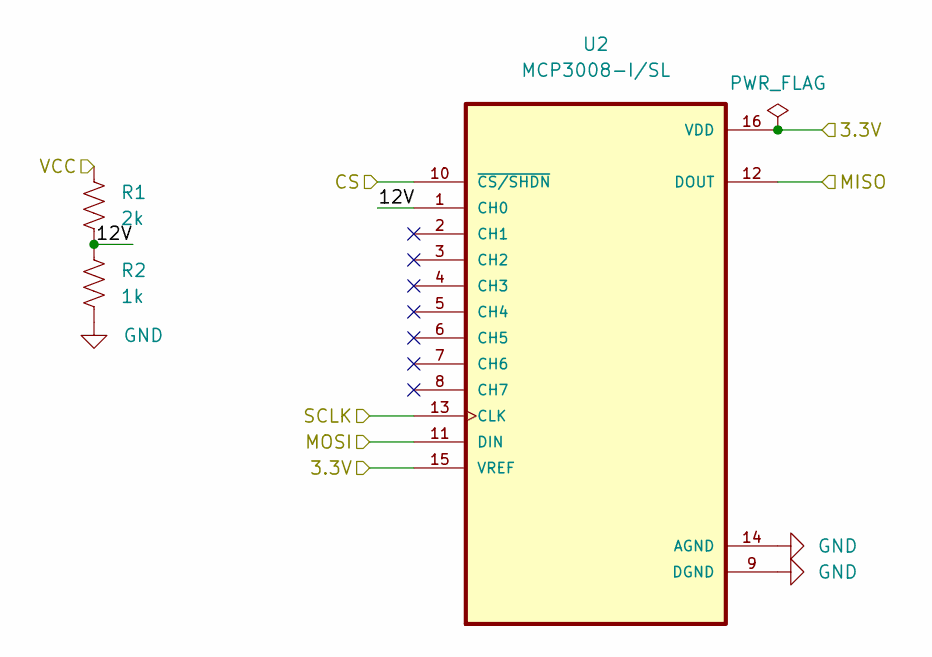
[picture p35: schematic A-D Converter.kicad_sch]

Parts:
R1: 2k; R_0805_2012Metric_Pad1.20x1.40mm_HandSolder
R2: 1k; R_0805_2012Metric_Pad1.20x1.40mm_HandSolder
U2: MCP3008-I/SL; SOIC127P600X175-16N

Connections:
/3.3V: U2.15 (VREF), U2.16 (VDD); also elsewhere on the board
/A-D Converter/12V: R1.1, R2.1, U2.1 (CH0)
/CS: U2.10 (~CS/SHDN); also elsewhere on the board
/MISO: U2.12 (DOUT); also elsewhere on the board
/MOSI: U2.11 (DIN); also elsewhere on the board
/SCLK: U2.13 (CLK); also elsewhere on the board
/VCC: R1.2; also elsewhere on the board
GND: R2.2, U2.9 (DGND), U2.14 (AGND); also elsewhere on the board

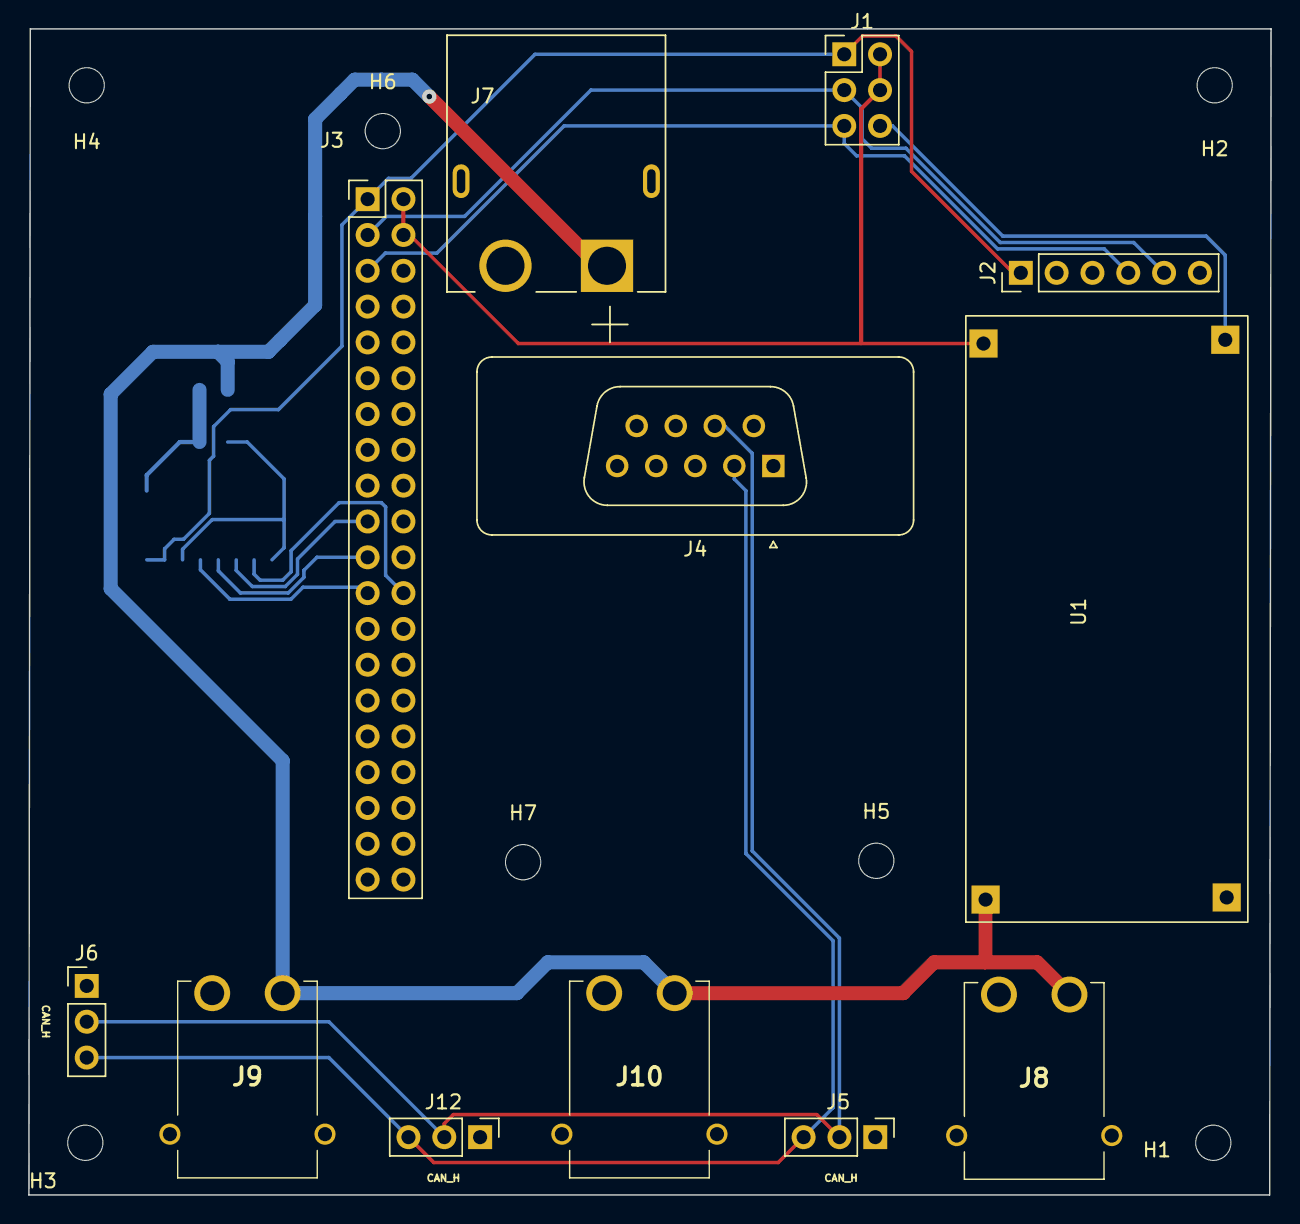
[picture p36: board MJBOTS-CubeSat.kicad_pcb from above]

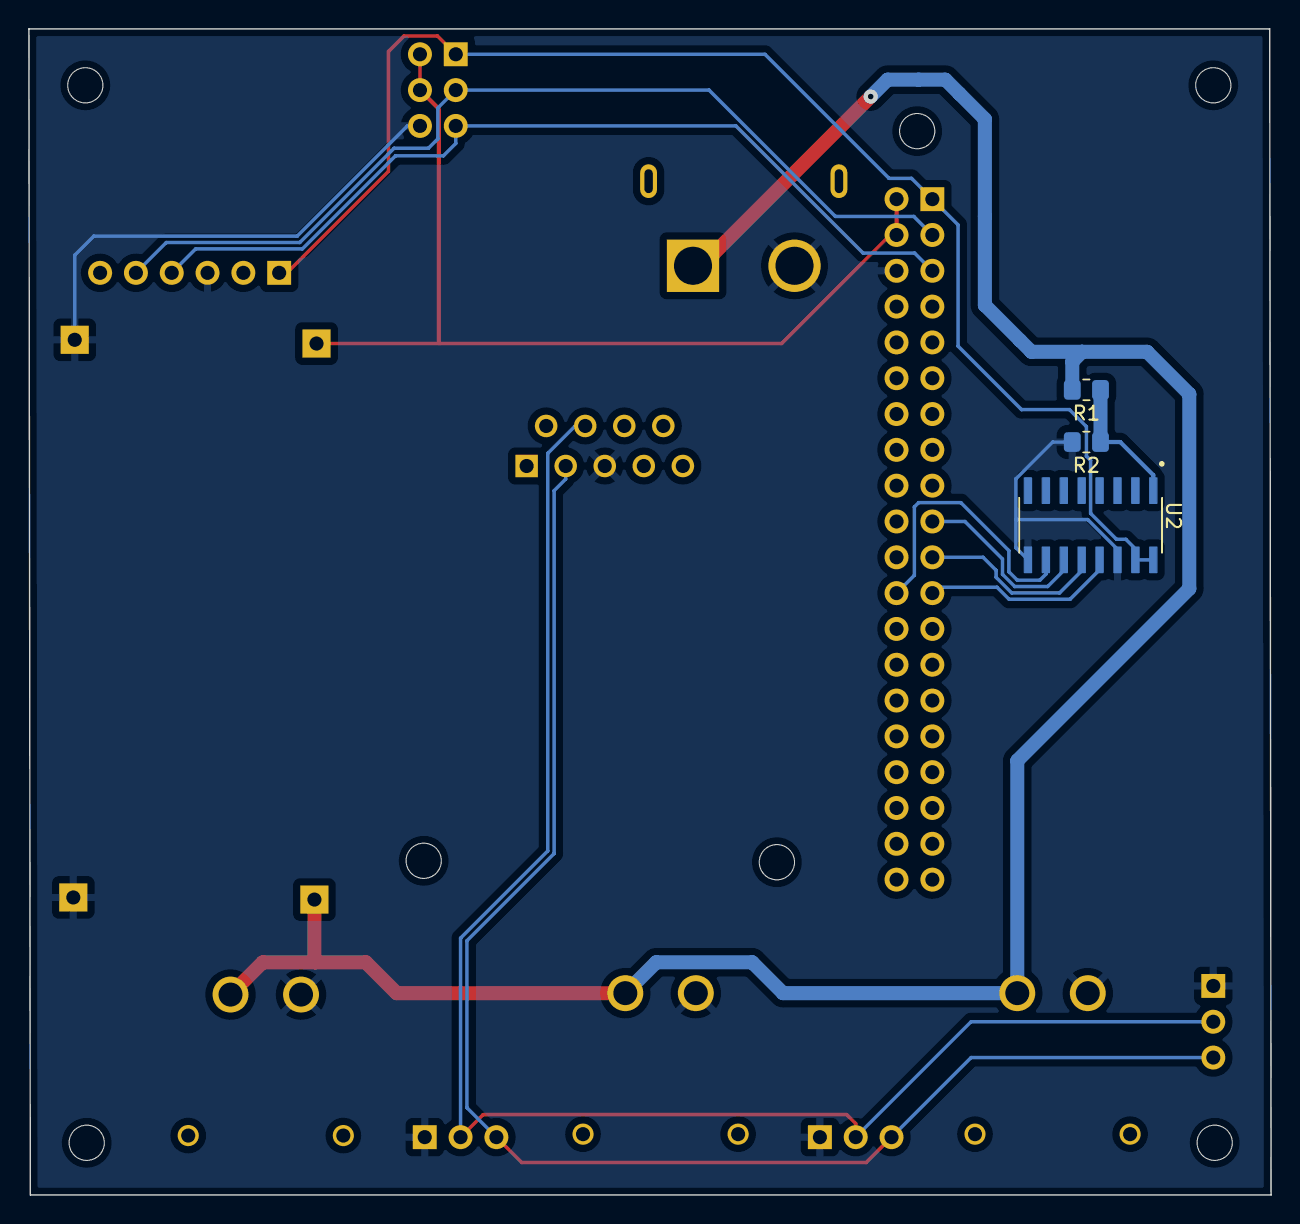
[picture p37: board MJBOTS-CubeSat.kicad_pcb from below]

Board: 2 copper layers, 88.1 x 82.7 mm, 22 parts (3 on the bottom side), 13 nets.
