danielwilczak101/EasyControls/ISAAC/PCB/Free_Flier_PCB/Free_Flier_PCB.kicad_pcb

## KiCad design ISAAC/PCB/Free_Flier_PCB/Free_Flier_PCB.kicad_pcb (2022-11-11)

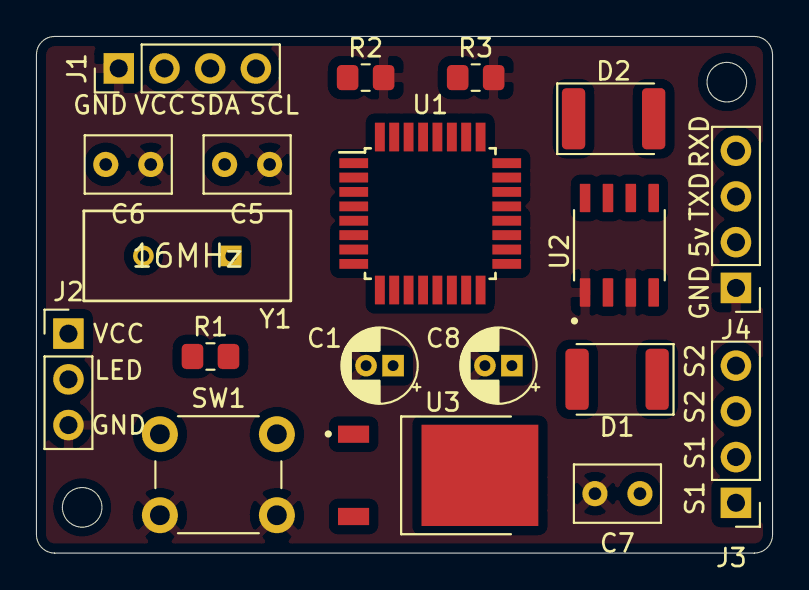
[picture p38: board Free_Flier_PCB.kicad_pcb from above]

Board: 2 copper layers, 40.9 x 28.7 mm, 21 parts (0 on the bottom side), 12 nets, no tracks yet.

Parts:
C1: 10uF; CP_Radial_D4.0mm_P1.50mm
C5, C6: 22pF; C_Rect_L4.6mm_W3.0mm_P2.50mm_MKS02_FKP02
C7: 0.33uF; C_Rect_L4.6mm_W3.0mm_P2.50mm_MKS02_FKP02
C8: 0.1uF; CP_Radial_D4.0mm_P1.50mm
D1, D2: DIODE; D_1812_4532Metric_Pad1.30x3.40mm_HandSolder
H1, H2: MountingHole; MountingHole_2.2mm_M2
J1: Power and Data Female; PinHeader_1x04_P2.54mm_Vertical
J2: LED Female; PinHeader_1x03_P2.54mm_Vertical
J3: Solenoid Conn; PinHeader_1x04_P2.54mm_Vertical
J4: Programming Pins Female; PinHeader_1x04_P2.54mm_Vertical
R1, R2, R3: 10K; R_0805_2012Metric_Pad1.20x1.40mm_HandSolder
SW1: SW_Push_Dual; SW_PUSH_6mm
U1: ATmega328P-AU; TQFP-32_7x7mm_P0.8mm
U2: DMN4026SSD; SOIC127P600X150-8N
U3: LM78M05CDTX/NOPB; TO228P991X255-3N
Y1: 16MHz; Abracon-ABL-16.000MHZ-B2-0

Connections:
+5V: C1.1, C8.1, J4.2, R1.1, SW1.1, U1.4 (VCC), U1.6 (VCC), U1.18 (AVCC), U1.20 (AREF), U3.1 (OUT)
/Gate1: R2.1, U1.10 (PD6), U2.2 (G1)
/Gate2: R3.1, U1.11 (PD7), U2.4 (G2)
/LED: J2.2, U1.9 (PD5)
/RXD: J4.4, U1.30 (PD0)
/SCL: J1.4, U1.28 (PC5)
/SDA: J1.3, U1.27 (PC4)
/SOL1: D1.1 (K), J3.1, U2.5 (D1), U2.6 (D1)
/SOL2: D2.1 (K), J3.3, U2.7 (D2), U2.8 (D2)
/TXD: J4.3, U1.31 (PD1)
GND: C1.2, C5.1, C6.1, C7.2, C8.2, J1.1, J2.3, J4.1, R2.2, R3.2, SW1.2, U1.3 (GND), U1.5 (GND), U1.21 (GND), U2.1 (S1), U2.3 (S2)
VCC: C7.1, D1.2 (A), D2.2 (A), J1.2, J2.1, J3.2, J3.4, U3.3 (IN)
