danielwilczak101/EasyControls/Cubesat/PCB/CubeSat/CubeSat.kicad_pcb

## KiCad design Cubesat/PCB/CubeSat/CubeSat.kicad_pcb (2022-10-08)

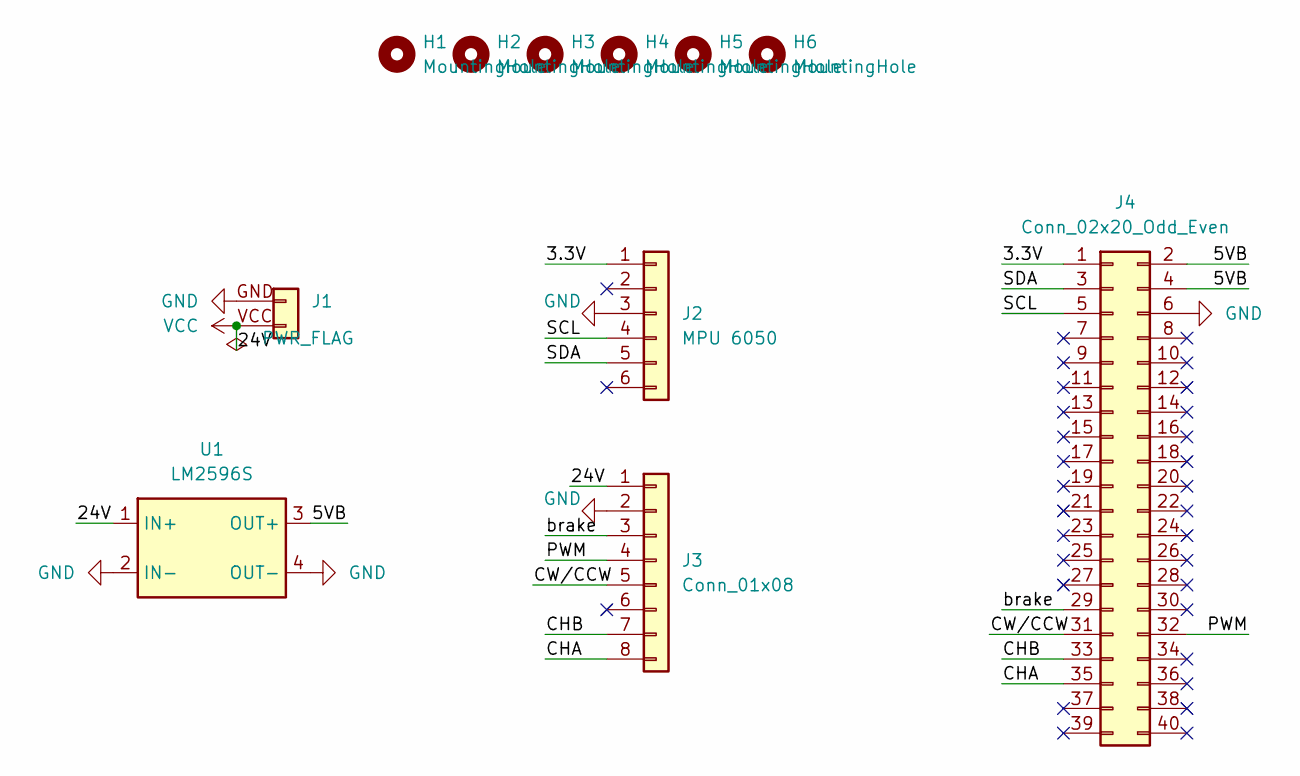
[picture p39: schematic CubeSat.kicad_sch]

Parts:
H1, H2, H3, H4, H5, H6: MountingHole; MountingHole_2.5mm
J1: Li 24V Battery; 24V_Li_batt
J2: MPU 6050; PinHeader_1x06_P2.54mm_Vertical
J3: Conn_01x08; PinHeader_1x08_P2.54mm_Vertical
J4: Conn_02x20_Odd_Even; PinHeader_2x20_P2.54mm_Vertical
U1: LM2596S; LM2596S_mod

Connections:
/3.3V: J2.1, J4.1
/5VB: J4.2, J4.4, U1.3 (OUT+)
/CHA: J3.8, J4.35
/CHB: J3.7, J4.33
/CW/CCW: J3.5, J4.31
/PWM: J3.4, J4.32
/SCL: J2.4, J4.5
/SDA: J2.5, J4.3
/brake: J3.3, J4.29
GND: J1.GND (Pin_1), J2.3, J3.2, J4.6, U1.2 (IN-), U1.4 (OUT-)
VCC: J1.VCC (Pin_2), J3.1, U1.1 (IN+)
