danielwilczak101/EasyControls/Cubesat/PCB/CubeSat/CubeSat.kicad_pcb

## KiCad design Cubesat/PCB/CubeSat/CubeSat.kicad_pcb (continued)

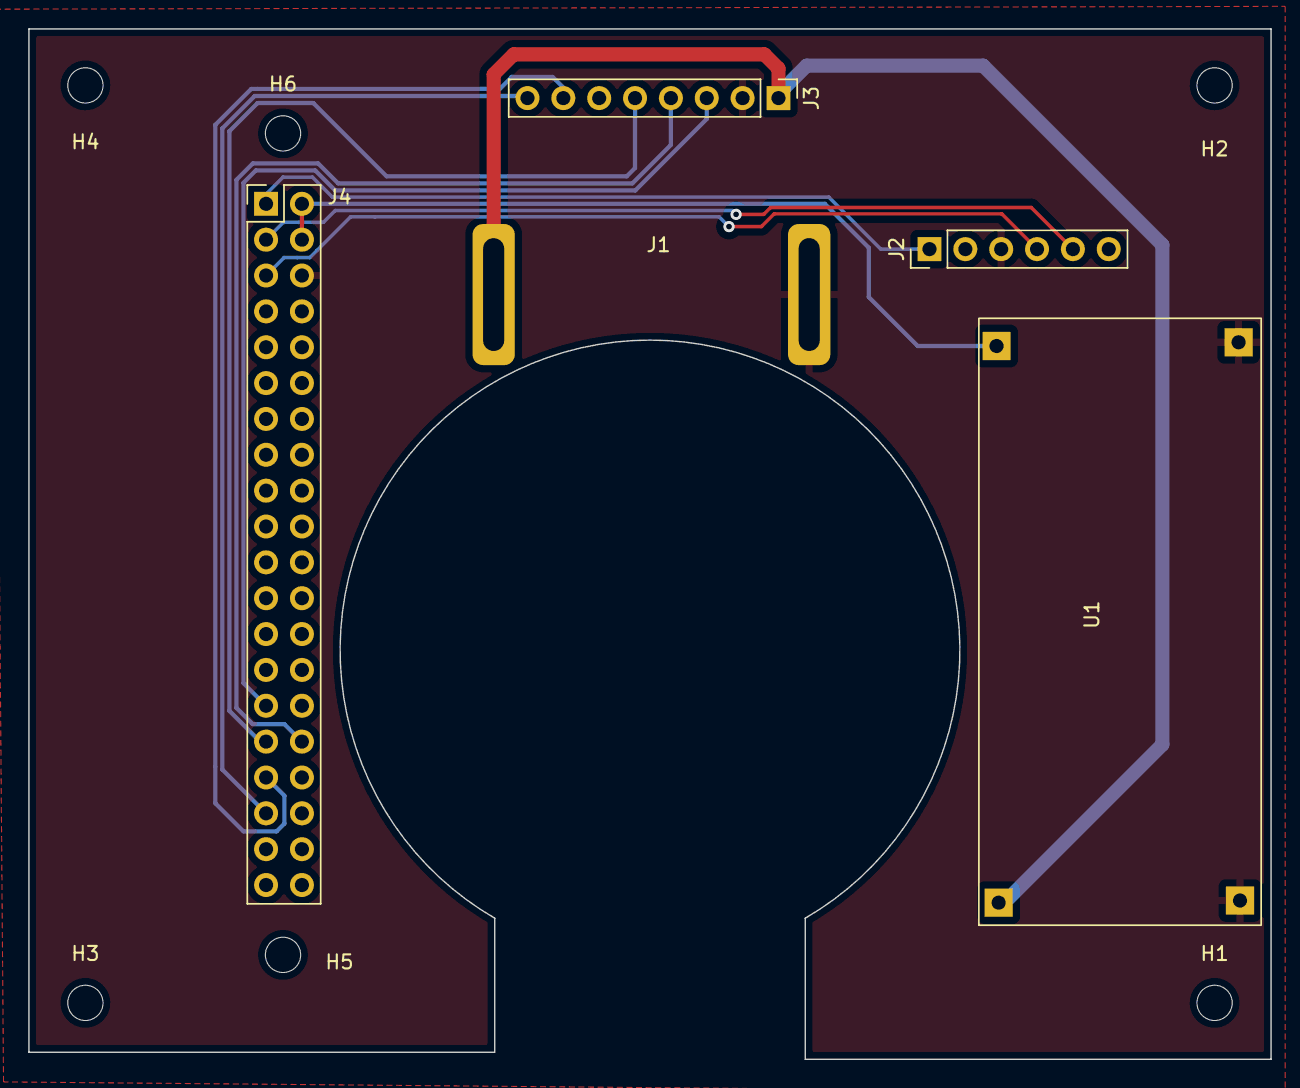
[picture p40: board CubeSat.kicad_pcb from above]

Board: 2 copper layers, 88.0 x 73.0 mm, 11 parts (0 on the bottom side), 11 nets.
