danielwilczak101/EasyControls/ISAAC/PCB/Spacecraft ATmega328 MOSFET/Spacecraft ATmega328 MOSFET.kicad_pcb

## KiCad design ISAAC/PCB/Spacecraft ATmega328 MOSFET/Spacecraft ATmega328 MOSFET.kicad_pcb (2022-10-03)

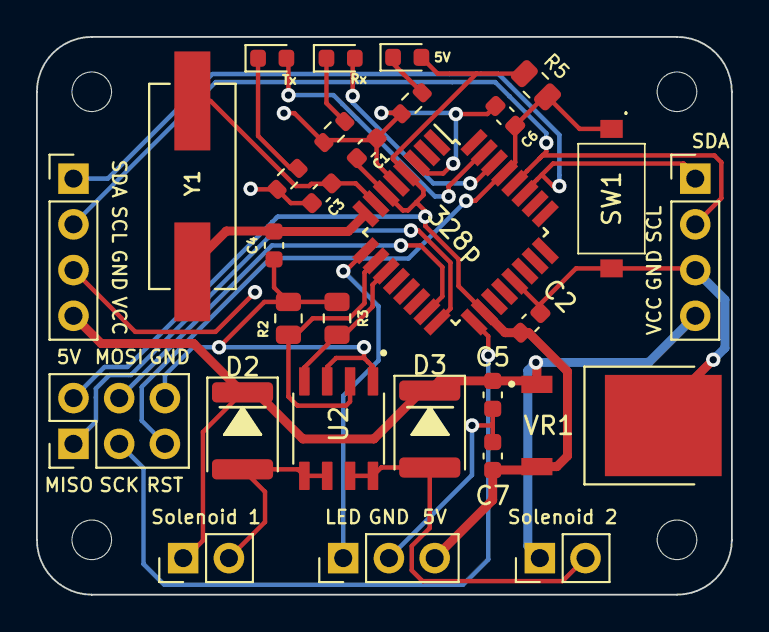
[picture p41: board Spacecraft ATmega328 MOSFET.kicad_pcb from above]

Board: 2 copper layers, 38.6 x 31.0 mm, 33 parts (0 on the bottom side), 21 nets.

Parts:
5V: LED; LED_0603_1608Metric
328p: ATmega328P-AU; TQFP-32_7x7mm_P0.8mm
C1, C2, C6: 100nF; C_0603_1608Metric
C3, C4: 22pf; C_0603_1608Metric
C5: 0.33 uF; C_0603_1608Metric
C7: 0.1uF; C_0603_1608Metric
D2, D3: D; D_1812_4532Metric
H1, H2, H3, H4: MountingHole; MountingHole_2.2mm_M2
J1, J2: I2C/Power_IN; PinHeader_1x04_P2.54mm_Vertical
J3: Bootloader Pins; PinHeader_2x03_P2.54mm_Vertical
J4: LED; PinHeader_1x03_P2.54mm_Vertical
J5: SOL_1; PinHeader_1x02_P2.54mm_Vertical
Jv: SOL_2; PinHeader_1x02_P2.54mm_Vertical
R2, R3, R5: 10k; R_0805_2012Metric
R6, R7, R8: 300; R_0603_1608Metric
Rx: LED; LED_0603_1608Metric
SW1: SW_Push; PTS636SK25SMTRLFS
Tx: LED; LED_0603_1608Metric
U2: DMN4026SSD; SOIC127P600X150-8N
VR1: LM78M05CDTX_NOPB; TO228P991X255-3N
Y1: Crystal; XTAL_ECS-160-20-5PXDN-TR

Connections:
+5V: 5V.2, 328p.4, 328p.6, 328p.18, C1.1, C2.1, C7.1, J3.2, J4.3, R5.1, VR1.3
/Gate1: 328p.10, R2.1, U2.2
/Gate2: 328p.11, R3.1, U2.4
/LED: 328p.9, J4.1
/MISO: 328p.16, J3.1
/MOSI: 328p.15, J3.4
/RXD: 328p.30, Rx.2
/Reset: 328p.29, C6.2, J3.5, R5.2, SW1.1
/SCK: 328p.17, J3.3
/SCL: 328p.28, J1.2, J2.2
/SDA: 328p.27, J1.1, J2.1
/SOL1: D2.2, J5.2, U2.5, U2.6
/SOL2: D3.2, Jv.2, U2.7, U2.8
/TXD: 328p.31, Tx.2
GND: 328p.3, 328p.5, 328p.21, C1.2, C2.2, C3.1, C4.1, C5.2, C6.1, C7.2, J1.3, J2.3, J3.6, J4.2, R2.2, R3.2, R6.1, R7.1, R8.1, SW1.2, U2.1, U2.3, VR1.4
unnamed: 328p.7, C3.2, Y1.1
unnamed: 328p.8, C4.2, Y1.2
unnamed: 5V.1, R6.2
unnamed: R7.2, Tx.1
unnamed: R8.2, Rx.1
VCC: C5.1, D2.1, D3.1, J1.4, J2.4, J5.1, Jv.1, VR1.1
