danielwilczak101/EasyControls/ISAAC/PCB/NANO_HAT/NANO_HAT/NANO_HAT.kicad_pcb

## KiCad design ISAAC/PCB/NANO_HAT/NANO_HAT/NANO_HAT.kicad_pcb (2022-10-03)

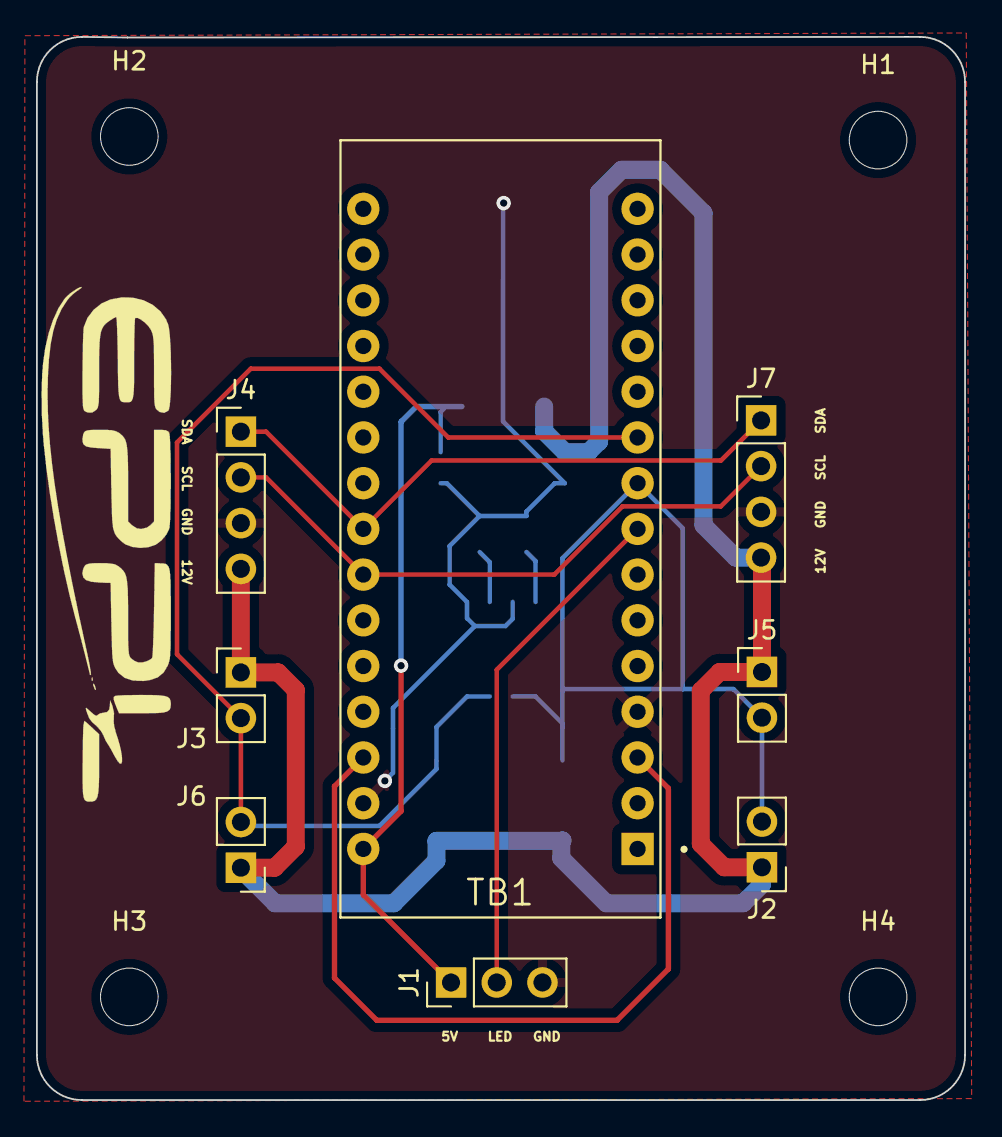
[picture p42: board NANO_HAT.kicad_pcb from above]

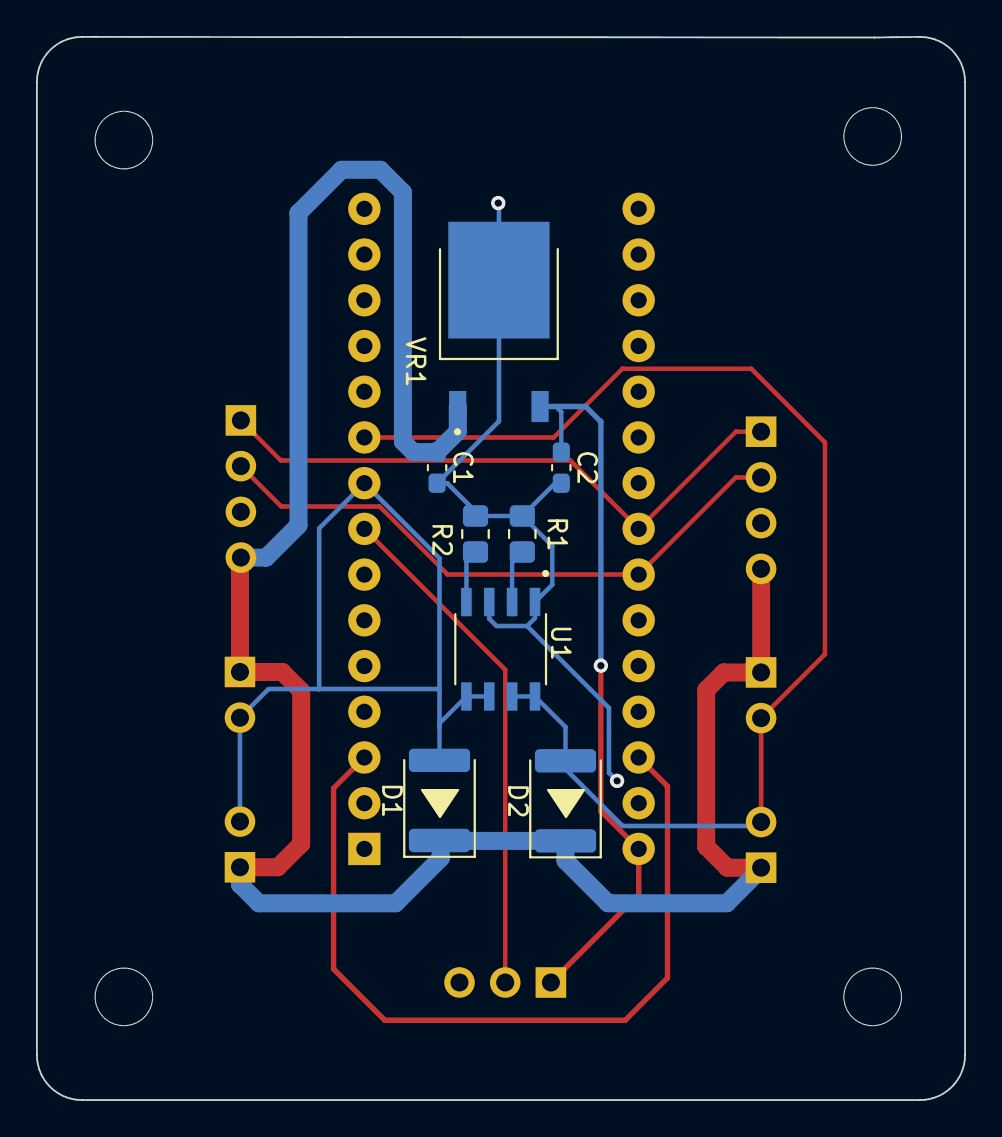
[picture p43: board NANO_HAT.kicad_pcb from below]

Board: 2 copper layers, 51.6 x 59.1 mm, 20 parts (8 on the bottom side), 10 nets.

Parts:
C1: 0.33 uF; C_0603_1608Metric_Pad1.08x0.95mm_HandSolder
C2: 0.1uF; C_0603_1608Metric_Pad1.08x0.95mm_HandSolder
D1, D2: D; D_1812_4532Metric_Pad1.30x3.40mm_HandSolder
H1, H2, H3, H4: MountingHole; MountingHole_3.2mm_M3
J1: Conn_01x03_Male; PinHeader_1x03_P2.54mm_Vertical
J2, J3, J5, J6: Conn_01x02_Male; PinHeader_1x02_P2.54mm_Vertical
J4, J7: Conn_01x04_Male; PinHeader_1x04_P2.54mm_Vertical
R1, R2: 10k; R_0805_2012Metric_Pad1.20x1.40mm_HandSolder
TB1: ARDUINO_NANO; SHIELD_ARDUINO_NANO
U1: DMN4026SSD; SOIC127P600X150-8N
VR1: LM78M05CDTX/NOPB; TO228P991X255-3N

Connections:
/5V: C2.1, J1.1, TB1.30 (VIN), VR1.3 (OUTPUT)
/Gate 1: R1.2, U1.2 (G1)
/Gate 2: R2.2, U1.4 (G2)
/LED: J1.2, TB1.8 (D5)
/SCL: J4.2, J7.2, TB1.24 (A5)
/SDA: J4.1, J7.1, TB1.23 (A4)
/SOL1: D1.2 (A), J2.2, J5.2, TB1.9 (D6), U1.5 (D1), U1.6 (D1)
/SOL2: D2.2 (A), J3.2, J6.2, TB1.10 (D7), U1.7 (D2), U1.8 (D2)
GND: C1.2, C2.2, J1.3, J4.3, J7.3, R1.1, R2.1, TB1.4 (COM/GND), TB1.29 (COM/GND), U1.1 (S1), U1.3 (S2), VR1.4 (GND)
VCC: C1.1, D1.1 (K), D2.1 (K), J2.1, J3.1, J4.4, J5.1, J6.1, J7.4, VR1.1 (INPUT)
