danielwilczak101/EasyControls/ISAAC/PCB/Pi_HAT/V1/Pi_HAT.kicad_pcb

## KiCad design ISAAC/PCB/Pi_HAT/V1/Pi_HAT.kicad_pcb (2022-09-25, an earlier design)

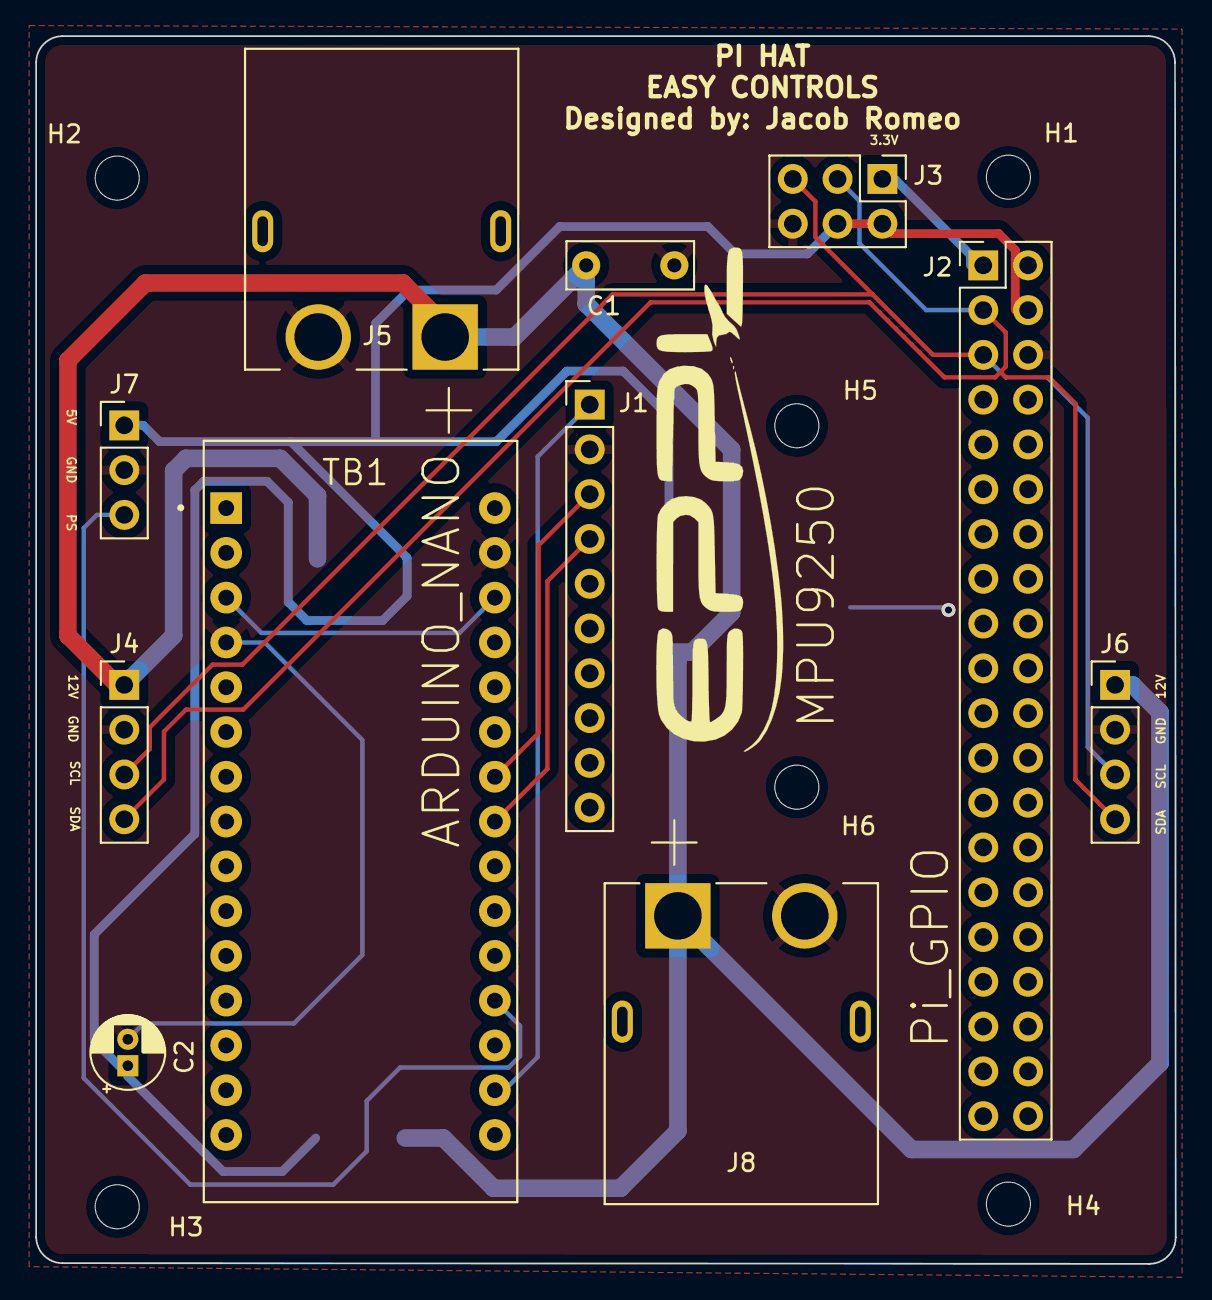
[picture p44: board Pi_HAT.kicad_pcb from above]

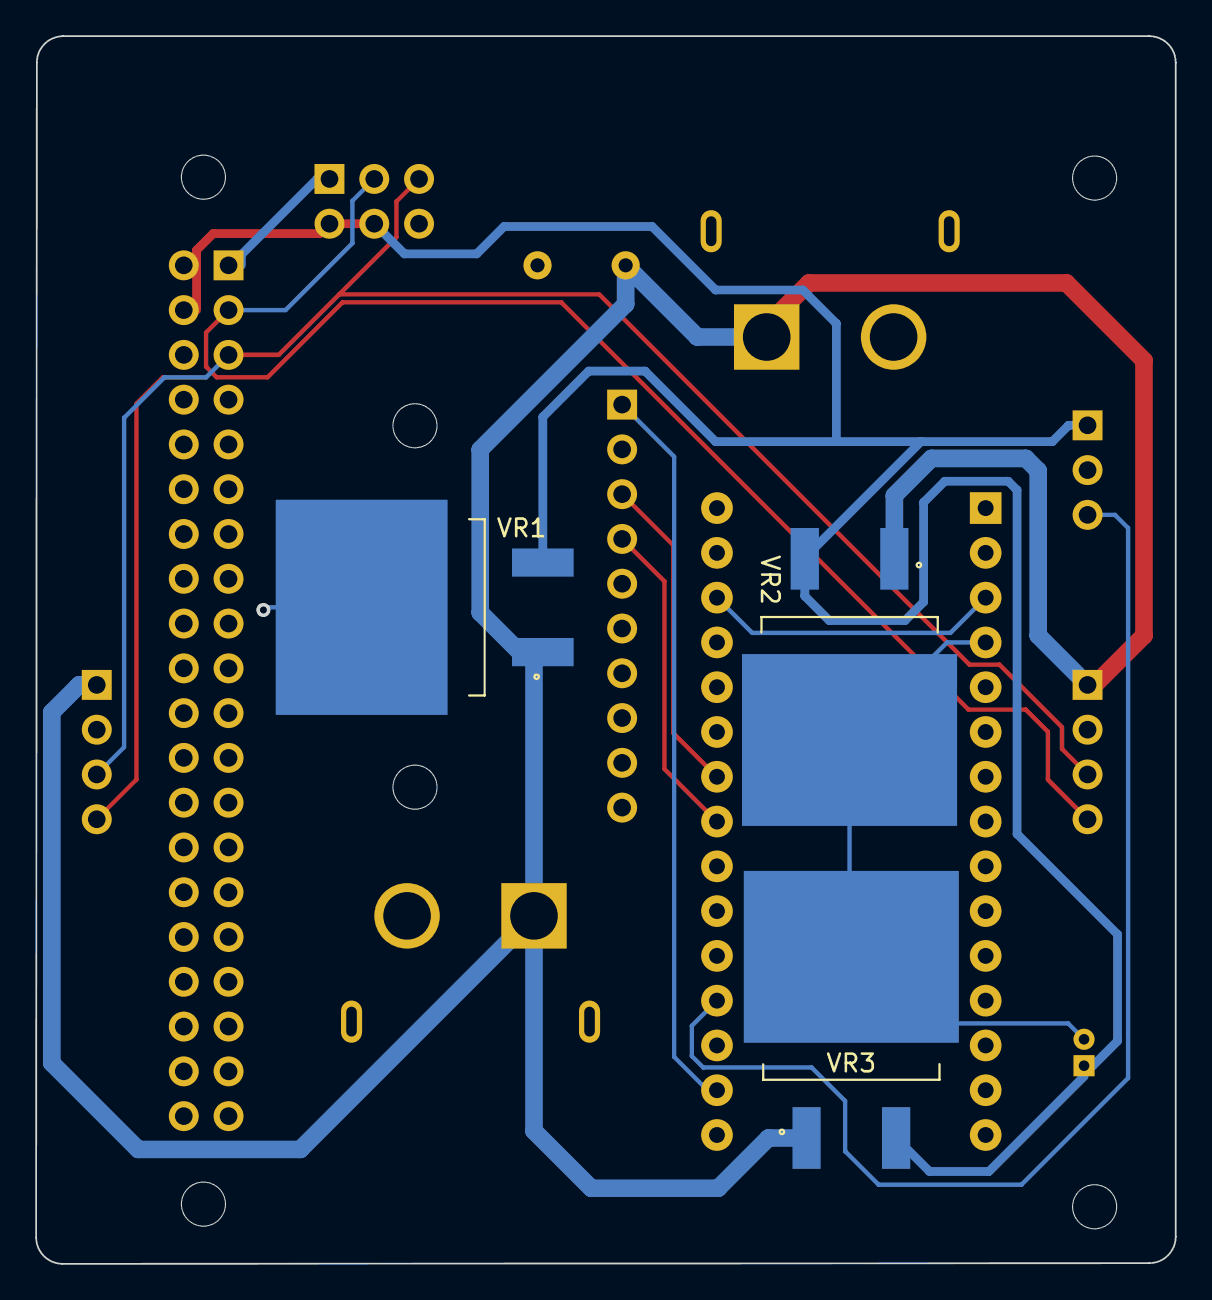
[picture p45: board Pi_HAT.kicad_pcb from below]

Board: 2 copper layers, 64.6 x 69.6 mm, 20 parts (3 on the bottom side), 10 nets.

Parts:
C1: C; C_Rect_L7.0mm_W2.5mm_P5.00mm
C2: C_Polarized; CP_Radial_D4.0mm_P1.50mm
H1, H2, H3, H4, H5, H6: MountingHole; MountingHole_2.5mm
J1: MPU9250; PinHeader_1x10_P2.54mm_Vertical
J2: Pi_GPIO; PinHeader_2x20_P2.54mm_Vertical
J3: Display; PinHeader_2x03_P2.54mm_Vertical
J4, J6: Solenoid I2C; PinHeader_1x04_P2.54mm_Vertical
J5, J8: XT60PW-M; AMASS_XT60PW-M
J7: Pressure; PinHeader_1x03_P2.54mm_Vertical
TB1: ARDUINO_NANO; SHIELD_ARDUINO_NANO
VR1, VR2, VR3: LM78M05CDTX/NOPB; VREG_L7805ACD2T

Connections:
3.3VN: J1.1, TB1.17 (3V3)
3.3VP: J2.1, J3.1
12V: C1.1, J4.1, J5.1 (+), J6.1, J8.1 (+), VR1.1 (INPUT), VR2.1 (INPUT), VR3.1 (INPUT)
/5V: C2.1, J2.2, J2.4, J3.2, J3.4, J7.1, VR1.3 (OUTPUT), VR2.3 (OUTPUT), VR3.3 (OUTPUT)
/PS: J7.3, TB1.19 (A0)
/SCL: J2.5, J3.5, J4.3, J6.3
/SDA: J2.3, J3.3, J4.4, J6.4
GND: C1.2, C2.2, J1.2, J2.6, J3.6, J4.2, J5.2 (-), J6.2, J7.2, J8.2 (-), TB1.4 (COM/GND), TB1.29 (COM/GND), VR1.4 (GND), VR2.4 (GND), VR3.4 (GND)
SCLN: J1.3, TB1.24 (A5)
SDAN: J1.4, TB1.23 (A4)
