danielwilczak101/EasyControls/Cubesat/raspberrypi/Moteus_Test/position_control.py

import asyncio
import math
import time
import moteus

async def main():
    c = moteus.Controller()

    for x in range(2000):
        print(await c.set_position(position=0.9*math.sin(math.pi*x/500), query = True))
        await asyncio.sleep(0.001)
    
    print (await c.set_stop(query = True))

           
asyncio.run(main())
