danielwilczak101/EasyControls/(commit log)

2021-11-03 Arduino cod for I2C turning LEDs on
    ~ This code was tested to see if the ATmega328P, acting as SLAVE, could receive instructions from the Raspberry Pi 3, acting as MASTER, via I2C. This was successful and we were able to turn 2 LEDs on/off via I2C.
2021-11-03 Uploading the file sketch of Arduino code for I2C
    ~ This was successfully tested with the ATmega328P chip, acting as the SLAVE, communicating via I2C with the Raspberry Pi 3, acting as MASTER. We turned 2 LEDs on/off communicating via I2C.
2021-11-03 Uploading the .py file for the master I2C code
    ~ This was successfully tested with the Raspberry Pi 3, acting as MASTER, communicating with the ATmega328P chip, acting as SLAVE via I2C. We turned 2 LEDs on/off communicating via I2C.
2021-11-04 Dev PCB
    [Free_Flier_PCB.kicad_pcb, Free_Flier_PCB.sch]
2021-11-04 Added led tutorial and led requirement.
    [Free_Flier_PCB.kicad_pcb, Free_Flier_PCB.sch]
2022-01-18 First upload of Arduino code for Free Flyer
2022-01-23 Arduino Code for IMU Rpi communication
2022-01-23 Python code to get IMU data from Arduino
2022-01-29 Adding code for mpu9250 for Arduino
2022-01-29 Adding code for receiving Serial data for python
    This is a small script for setting up your Pi to basically mirror your Arduino's Serial Monitor.
2022-02-24 Jacks Solenoid Control Code
2022-04-09 Created Pi HAT
    Pi HAT for Free Flyer Solenoids and NANO
    [Free_Flier_PCB.kicad_pcb, Free_Flier_PCB.sch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]
2022-04-10 Added logo
    [Pi_HAT-B_Cu.gbr, Pi_HAT-B_Mask.gbr, Pi_HAT-B_Paste.gbr, Pi_HAT-B_SilkS.gbr, Pi_HAT-Edge_Cuts.gbr, Pi_HAT-F_Cu.gbr, Pi_HAT-F_Mask.gbr, Pi_HAT-F_Paste.gbr]
2022-04-24 Changed Footprints
    Changed the regulator's footprint and added XT-60
    [Pi_HAT-B_Cu.gbr, Pi_HAT-B_Mask.gbr, Pi_HAT-B_Paste.gbr, Pi_HAT-B_SilkS.gbr, Pi_HAT-B_Silkscreen.gbr, Pi_HAT-Edge_Cuts.gbr, Pi_HAT-F_Cu.gbr, Pi_HAT-F_Mask.gbr]
2022-04-26 Upload new PCB with ATmega328p w/ MOSFET
    [Spacecraft ATmega328 w:MOSFET.kicad_pcb, Spacecraft ATmega328 w:MOSFET.sch]
2022-04-26 update PCB Kicad Libaries
2022-04-28 Update PCB files
    [BOB-12009.step, ECS-160-20-5PXDN-TR.step, Spacecraft ATmega328 MOSFET.kicad_pcb, Spacecraft ATmega328 MOSFET.sch, T491A104K035AT.step]
2022-04-28 Deleted wrong PCB file name
    [BOB-12009.step, ECS-160-20-5PXDN-TR.step, Spacecraft ATmega328 w:MOSFET.kicad_pcb, Spacecraft ATmega328 w:MOSFET.sch, T491A104K035AT.step]
2022-04-29 Finished Tracing
    [Spacecraft ATmega328 MOSFET.kicad_pcb, Spacecraft ATmega328 MOSFET.kicad_sch]
2022-04-29 Made Gerber file
    [Spacecraft ATmega328 MOSFET-B_Cu.gbr, Spacecraft ATmega328 MOSFET-B_Mask.gbr, Spacecraft ATmega328 MOSFET-B_Paste.gbr, Spacecraft ATmega328 MOSFET-B_Silkscreen.gbr, Spacecraft ATmega328 MOSFET-Edge_Cuts.gbr, Spacecraft ATmega328 MOSFET-F_Cu.gbr, Spacecraft ATmega328 MOSFET-F_Mask.gbr, Spacecraft ATmega328 MOSFET-F_Paste.gbr]
2022-08-22 Pi_HAT V2
    [Pi_HAT.kicad_pcb, Pi_HAT.kicad_sch, Pi_HAT.sch, Pi_HAT_V2.kicad_pcb, Pi_HAT_V2.kicad_sch, Pi_HAT_V2.sch, VREG_L7805ACD2T.step, Voltage Reg.kicad_sch]
2022-08-22 Still more to do
    [Pi_HAT_V2.kicad_pcb, Pi_HAT_V2.kicad_sch, Voltage Reg.kicad_sch]
2022-09-02 Updated thruster numbers
2022-09-02 Thruster number test
2022-09-02 Updated website code to add thrusters.
2022-09-03 updated print
2022-09-03 Added gyro scope
2022-09-03 Updated with gyro balance
2022-09-08 Finished Buch .sch
    Next need to start/finish the PCB traces
    [BSS138_RFG.step, Buck Converter.kicad_sch, Level Shifter.kicad_sch, Pi_HAT_V2.kicad_pcb, Pi_HAT_V2.kicad_sch]
2022-09-08 Added Extra I2C Header
    [Pi_HAT.kicad_pcb, Pi_HAT.kicad_sch, Voltage Reg.kicad_sch]
2022-09-08 Gerber for V1 Pi_HAT
    Order this one along with the Buck Converter PCB
    [Pi_HAT-B_Cu.gbr, Pi_HAT-B_Mask.gbr, Pi_HAT-B_Paste.gbr, Pi_HAT-B_Silkscreen.gbr, Pi_HAT-Edge_Cuts.gbr, Pi_HAT-F_Cu.gbr, Pi_HAT-F_Mask.gbr, Pi_HAT-F_Paste.gbr]
2022-09-10 Updated
    Added NANO_HAT and finished the PI_HAT V2 .sch, need to start/finish traces
    [BOB-12009.step, Buck Converter.kicad_sch, ECS-160-20-5PXDN-TR.step, Level Shifter.kicad_sch, NANO_HAT.kicad_pro.kicad_pcb, NANO_HAT.kicad_pro.kicad_sch, NANO_HAT.kicad_pro.sch, Pi_HAT_V2.kicad_pcb]
2022-09-12 Updated V1 Pi Hat
    [Pi_HAT.kicad_pcb, Pi_HAT.kicad_sch, Voltage Reg.kicad_sch]
2022-09-13 Added velocity to the gyro data
2022-09-13 Print velocity
2022-09-14 Created NANO_HAT
    [NANO_HAT.kicad_pcb, NANO_HAT.kicad_sch]
2022-09-14 updated NANO_HAT
    [NANO_HAT.kicad_pcb]
2022-09-15 Finished V1
    [Pi_HAT.kicad_pcb, Pi_HAT.kicad_sch, Voltage Reg.kicad_sch]
2022-09-15 Updated (Gerber)
    [Buck Converter.kicad_sch, Level Shifter.kicad_sch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]
2022-09-16 NANO_HAT Update 2
    [NANO_HAT.kicad_pcb]
2022-09-19 Finished Pi HAT V2
    Double checked all 'new' PCB's and made gerbers for all along with a BOM.
    [Buck Converter.kicad_sch, Level Shifter.kicad_sch, NANO_HAT.csv, Pi_HAT.csv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]
2022-09-23 Added CubeSat PCB
    Still needs to be finished
    [Buck Converter.kicad_sch, CubeSat.kicad_pcb, CubeSat.kicad_sch, CubeSat.step, Level Shifter.kicad_sch, Pi_HAT_V2.kicad_pcb, Pi_HAT_V2.kicad_sch]
2022-09-23 Finished/Uploaded Gerber
    [CubeSat-B_Cu.gbr, CubeSat-B_Mask.gbr, CubeSat-B_Paste.gbr, CubeSat-B_Silkscreen.gbr, CubeSat-Edge_Cuts.gbr, CubeSat-F_Cu.gbr, CubeSat-F_Mask.gbr, CubeSat-F_Paste.gbr]
2022-10-02 Made BOM file // READY to order
    [Buck Converter.kicad_sch, Level Shifter.kicad_sch, Pi_HAT_V2.csv, Pi_HAT_V2.kicad_sch]
2022-10-03 Fixed NANO_HAT
    [NANO_HAT.kicad_pcb, NANO_HAT.kicad_sch, Spacecraft ATmega328 MOSFET.kicad_pcb, Spacecraft ATmega328 MOSFET.kicad_sch]
2022-10-03 Uploaded Gerber
    [NANO_HAT-B_Cu.gbr, NANO_HAT-B_Mask.gbr, NANO_HAT-B_Paste.gbr, NANO_HAT-B_Silkscreen.gbr, NANO_HAT-Edge_Cuts.gbr, NANO_HAT-F_Cu.gbr, NANO_HAT-F_Mask.gbr, NANO_HAT-F_Paste.gbr]
2022-10-03 Updated V2 Pi HAT CSV
    [Pi_HAT_V2.csv]
2022-10-06 Coded motor test
2022-10-06 Moved some files around for CubeSat
    [CubeSat-B_Cu.gbr, CubeSat-B_Mask.gbr, CubeSat-B_Paste.gbr, CubeSat-B_Silkscreen.gbr, CubeSat-Edge_Cuts.gbr, CubeSat-F_Cu.gbr, CubeSat-F_Mask.gbr, CubeSat-F_Paste.gbr]
2022-10-06 Changed direction and brake
2022-10-06 Changed brake
2022-10-06 While loop for PWM
2022-10-07 added error for target
    [mpu_and_motor_test.py]
2022-10-07 added print statements
2022-10-08 Updated pin direction
2022-10-08 Fixed PCB
    [CubeSat-B_Cu.gbr, CubeSat-B_Mask.gbr, CubeSat-B_Paste.gbr, CubeSat-B_Silkscreen.gbr, CubeSat-Edge_Cuts.gbr, CubeSat-F_Cu.gbr, CubeSat-F_Mask.gbr, CubeSat-F_Paste.gbr]
2022-10-16 printing things
2022-10-17 Lost max velocity
2022-10-22 Updated ISAAC & CubeSat
    Created Pi HAT V3 PCB and new CubeSat PCB
    [A-D Converter.kicad_sch, BSS138_RFG.step, Buck Converter.kicad_sch, Free_Flier_PCB.kicad_pcb, Free_Flier_PCB.kicad_sch, Level Shifter.kicad_sch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]
2022-10-24 Updated Moteus PCB
    [A-D Converter.kicad_sch, MJBOTS-CubeSat.kicad_pcb, MJBOTS-CubeSat.kicad_sch, Pi_HAT_V3.kicad_sch]
2022-10-28 Update solenoid.ino
    Updated neo pin name.
2022-10-29 Updated CubeSat PCB
    Still need the dimensions for the CAN bus converter
    [MJBOTS-CubeSat-B_Cu.gbr, MJBOTS-CubeSat-B_Mask.gbr, MJBOTS-CubeSat-B_Paste.gbr, MJBOTS-CubeSat-B_Silkscreen.gbr, MJBOTS-CubeSat-Edge_Cuts.gbr, MJBOTS-CubeSat-F_Cu.gbr, MJBOTS-CubeSat-F_Mask.gbr, MJBOTS-CubeSat-F_Paste.gbr]
2022-10-31 Updated CubeSat PCB
    [MJBOTS-CubeSat.kicad_pcb, MJBOTS-CubeSat.kicad_sch]
2022-11-02 Traced V3
    [Pi_HAT_V2.kicad_pcb, Pi_HAT_V3.kicad_pcb]
2022-11-03 Finished CubeSat PCB
    Uploaded gerber.zip
    [MJBOTS-CubeSat-B_Cu.gbr, MJBOTS-CubeSat-B_Mask.gbr, MJBOTS-CubeSat-B_Paste.gbr, MJBOTS-CubeSat-B_Silkscreen.gbr, MJBOTS-CubeSat-Edge_Cuts.gbr, MJBOTS-CubeSat-F_Cu.gbr, MJBOTS-CubeSat-F_Mask.gbr, MJBOTS-CubeSat-F_Paste.gbr]
2022-11-04 Added .step file
    [CubeSat.step, MJBOTS-CubeSat.kicad_pcb, MJBOTS-CubeSat.step]
2022-11-11 Changed max velocity
2022-11-13 added print statement
2022-11-13 added goal velocity
2022-11-14 Changed velocity
2022-11-14 max torquee
2022-11-14 added brake
2022-11-21 Shit ton of stuf
    [A-D Converter.kicad_sch, BSS138_RFG.step, Buck Converter.kicad_sch, Level Shifter.kicad_sch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]
2022-11-23 Final Updates "HOPEFULLY"
    [A-D Converter.kicad_sch, Buck Converter.kicad_sch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]
2022-11-24 modified: Start_Stop.py motor_control.py mpu_degrees.py
2022-11-26 Cleaned up moteus folder; added motor/mpu script
2022-11-28 Added new file: PID control
2022-11-29 Added PID!
2022-12-02 added stop motor file
2023-02-20 Added 1DoF Pid
2023-02-22 Solved Angle Problem. Range from 0 to 360
    [1DOFControl.py]
2023-03-09 Added IMU File
2023-03-24 Updated PID code
2023-04-03 Added code for 9DOF Board
2023-09-06 Updated code: Sorta works
    [A-D Converter.kicad_sch, Buck Converter.kicad_sch, Level Shifter.kicad_sch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]
2023-09-18 Updated
    Started SPARK grant and updated controller and PCB
    [A-D Converter.kicad_sch, Buck Converter.kicad_sch, ISAAC-Purchase-Form.xlsx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]
2024-01-24 Updated ISAAC PCB
    [A-D Converter.kicad_sch, BSS138_RFG.step, Buck Converter.kicad_sch, Level Shifter.kicad_sch, Pi_HAT_V4.kicad_pcb, Pi_HAT_V4.kicad_sch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]
2024-01-24 Updated lmao
    [Pi_HAT_V4_Simple-B_Cu.gbr, Pi_HAT_V4_Simple-B_Mask.gbr, Pi_HAT_V4_Simple-B_Paste.gbr, Pi_HAT_V4_Simple-B_Silkscreen.gbr, Pi_HAT_V4_Simple-Edge_Cuts.gbr, Pi_HAT_V4_Simple-F_Cu.gbr, Pi_HAT_V4_Simple-F_Mask.gbr, Pi_HAT_V4_Simple-F_Paste.gbr]
2024-02-05 Updated pcb
2024-03-04 made new V5 PCB
    [A-D Converter.kicad_sch, BSS138_RFG.step, Buck Converter.kicad_sch, Level Shifter.kicad_sch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]
2024-04-08 added pressure stuff
2024-04-27 add code to stream imu data to unity
2024-04-27 update unity to have prints and run until program killed
2024-09-28 Creating DOC! Finally! Pls Don't forget about me!
    [ISAAC-Purchase-Form.xlsx]
2024-09-28 now third time is the charm
    [ISAAC-Purchase-Form.xlsx]
