danielwilczak101/EasyControls/ISAAC/testing/atmega328P_standalone_chip/images/three.JPG

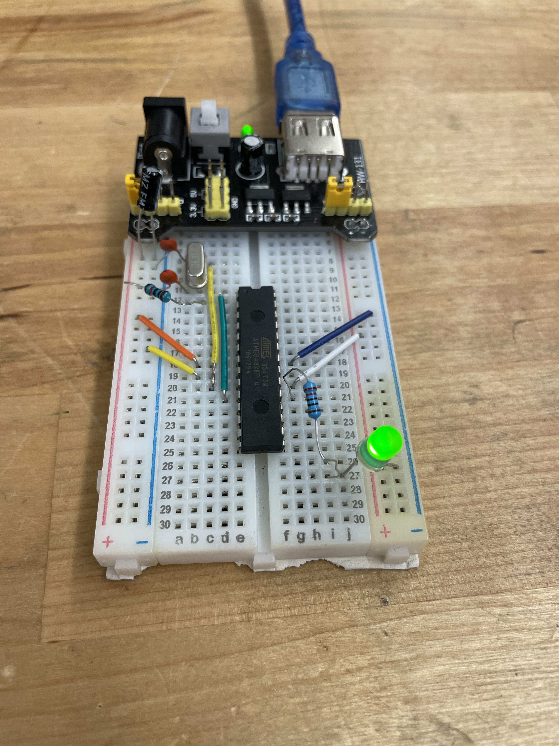
[picture p18: ISAAC/testing/atmega328P_standalone_chip/images/three.JPG]
ISAAC/testing/atmega328P_standalone_chip/images/three.JPG
