danielwilczak101/EasyControls/ISAAC/testing/atmega328P_standalone_chip/images/four.JPG

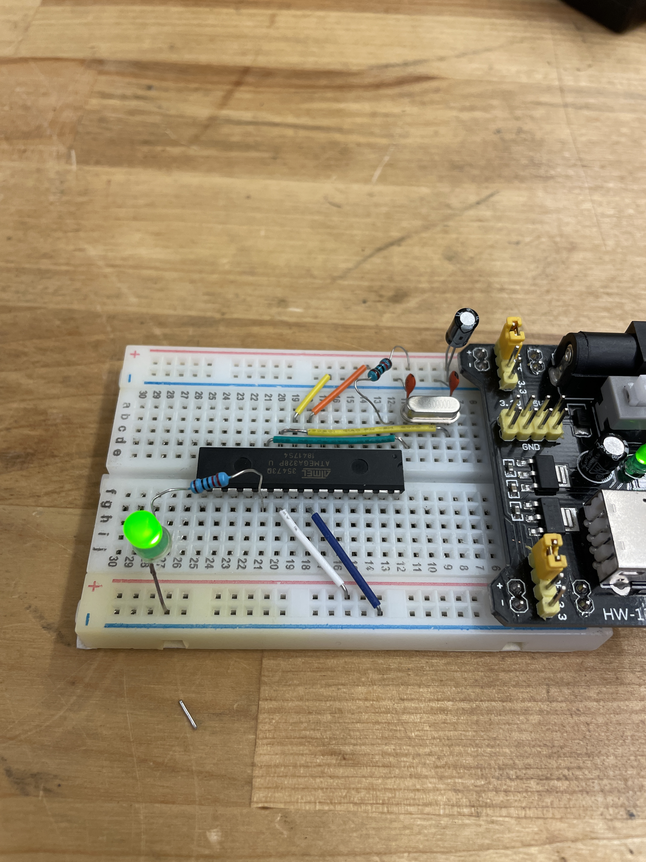
[picture p19: ISAAC/testing/atmega328P_standalone_chip/images/four.JPG]
ISAAC/testing/atmega328P_standalone_chip/images/four.JPG
