danielwilczak101/EasyControls/ISAAC/testing/thruster_force/images/3.JPG

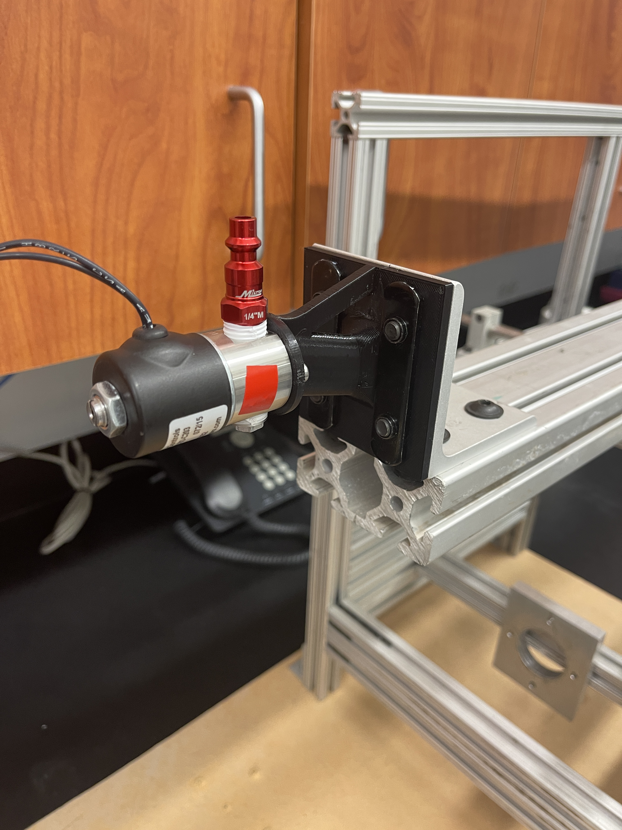
[picture p23: ISAAC/testing/thruster_force/images/3.JPG]
ISAAC/testing/thruster_force/images/3.JPG
